LeoWPereira/Dalle-Pad/README.md

# Dalle-Pad
Projeto de Oficinas de Integração 3. Dalle Pad (C) - O Gadget que te transforma em um DJ 

Para que seja possível o completo acompanhamento do projeto, a leitura de todos os itens dentro da pasta "Referências Bibliográficas" é OBRIGATÓRIA!!
