LeoWPereira/Dalle-Pad/LaTeX Project/Apendice.tex

%%
%% Apendice.tex
%% Projeto Oficinas de Integração 3
%% Created by Leonardo Winter Pereira and Lucas Zimmermann Cordeiro on 10.03.2016
%% Copyright (C). All rights reserved
%%

%% Apêndice é um texto ou documento elaborado pelo autor do TC, ou seja,
%% se foi necessário você criar uma entrevista, um relatório, ou qualquer
%% documento com o escopo de complementar sua argumentação

\definecolor{darkRed}{rgb}{0.607843137254902, 0.1764705882352941, 0.1215686274509804}
\definecolor{lightRed}{rgb}{0.9568627450980392, 0.803921568627451, 0.7843137254901961}

\newcolumntype{C}[1]{>{\centering\let\newline\\\arraybackslash\hspace{0pt}}m{#1}}

\chapter{Datasheets}
\label{chap:Team_datasheets}

\chapter{Notas musicais em MIDI}

    O estudo da música em si está fora do escopo deste projeto. Entretanto, é imprescindível entender o que é uma oitava. Segue uma breve definição: \epigraph{Uma oitava é o intervalo entre uma nota musical e outra com a metade ou o dobro de sua frequência.}{~\cite{WikipediaOitava}}

    Dizer que uma nota está uma oitava acima significa dizer que a nota é a mesma, porém ela está em uma região mais aguda do instrumento.

    \begin{table}[H]
        \centering
        \begin{tabular}{| c | c | c | c | c | c | c | c | c | c | c | c | c |}
            \hline
            \rowcolor{darkRed} & \multicolumn{12}{c|}{\textcolor{white}{\textbf{Número referente a nota}}} \\
            \cline{2-13}
            \rowcolor{darkRed} \multirow{-2}{*}{\textcolor{white}{\textbf{Oitava}}} & \textcolor{white}{\textbf{C}} & \textcolor{white}{\textbf{C\#}} & \textcolor{white}{\textbf{D}} & \textcolor{white}{\textbf{D\#}} & \textcolor{white}{\textbf{E}} & \textcolor{white}{\textbf{F}} & \textcolor{white}{\textbf{F\#}} & \textcolor{white}{\textbf{G}} & \textcolor{white}{\textbf{G\#}} & \textcolor{white}{\textbf{A}} & \textcolor{white}{\textbf{A\#}} & \textcolor{white}{\textbf{B}} \\
            \hline
            \rowcolor{lightRed} \textbf{-1} &  0   & 1   & 2   & 3   & 4   & 5   & 6   & 7   & 8   & 9   & 10 & 11 \\
            \hline
            \rowcolor{white}     \textbf{0} &  12  & 13  & 14  & 15  & 16  & 17  & 18  & 19  & 20  & 21  & 22 & 23 \\
            \hline
            \rowcolor{lightRed}  \textbf{1} &  24  & 25  & 26  & 27  & 28  & 29  & 30  & 31  & 32  & 33  & 34 & 35 \\
            \hline
            \rowcolor{white}     \textbf{2} &  36  & 37  & 38  & 39  & 40  & 41  & 42  & 43  & 44  & 45  & 46 & 47 \\
            \hline
            \rowcolor{lightRed}  \textbf{3} &  48  & 49  & 50  & 51  & 52  & 53  & 54  & 55  & 56  & 57  & 58 & 59 \\
            \hline
            \rowcolor{white}     \textbf{4} &  60  & 61  & 62  & 63  & 64  & 65  & 66  & 67  & 68  & 69  & 70 & 71 \\
            \hline
            \rowcolor{lightRed}  \textbf{5} &  72  & 73  & 74  & 75  & 76  & 77  & 78  & 79  & 80  & 81  & 82 & 83 \\
            \hline
            \rowcolor{white}     \textbf{6} &  84  & 85  & 86  & 87  & 88  & 89  & 90  & 91  & 92  & 93  & 94 & 95 \\
            \hline
            \rowcolor{lightRed}  \textbf{7} &  96  & 97  & 98  & 99  & 100 & 101 & 102 & 103 & 104 & 105 & 106 & 107 \\
            \hline
            \rowcolor{white}     \textbf{8} &  108 & 109 & 110 & 111 & 112 & 113 & 114 & 115 & 116 & 117 & 118 & 119 \\
            \hline
            \rowcolor{lightRed}  \textbf{9} &  120 & 121 & 122 & 123 & 124 & 125 & 126 & 127 &     &     &     &     \\
            \hline
        \end{tabular}
        \caption{Notas musicais em MIDI}
        \label{table:MIDI_notes}
    \end{table}

\chapter{Especificação MIDI}

    As seguintes tabelas representam a especificação MIDI, atualizada em 1995 pela \sigla{MMA}{MIDI Manufacturers Association} (Associação dos Fabricantes de MIDI, em inglês), que define o protocolo MIDI.

    \section{Bytes de estado}

        Nas tabelas a seguir, separadas entre os possíveis estados de uma mensagem MIDI, serão citados todos os possíveis valores de \textit{bytes} de estado e o que cada um deles representa.

        %%%%%%%%%%%%%%%%%%%%%%%%%%%%%%%%%%%%%%%%%
        %                                       %
        %             Tabela B.1                %
        %                                       %
        %%%%%%%%%%%%%%%%%%%%%%%%%%%%%%%%%%%%%%%%%

        \begin{center}
        \tablefirsthead{%
          \hline
          \rowcolor{darkRed} \multicolumn{4}{c}{\textcolor{white}{\textbf{Byte de estado}}} & \multicolumn{2}{c}{\textcolor{white}{\textbf{Byte de dados}}} \\
          \hline
          \rowcolor{darkRed} \textcolor{white}{\textbf{\shortstack{1$^\circ$ Byte \\ Binário}}} & \textcolor{white}{\textbf{\shortstack{1$^\circ$ Byte \\ Hexa}}} & \textcolor{white}{\textbf{\shortstack{1$^\circ$ Byte \\ Decimal}}} & \textcolor{white}{\textbf{\shortstack{Função \\ Note OFF}}} & \textcolor{white}{\textbf{2$^\circ$ Byte}} & \textcolor{white}{\textbf{3$^\circ$ Byte}} \\
          \hline}
        \tablehead{%
          \hline
          \multicolumn{6}{|l|}{\small\sl continuação da página anterior} \\
          \hline
          \rowcolor{darkRed} \multicolumn{4}{c|}{\textcolor{white}{\textbf{Byte de estado}}} & \multicolumn{2}{c|}{\textcolor{white}{\textbf{Byte de dados}}} \\
          \hline
          \rowcolor{darkRed} \textcolor{white}{\textbf{\shortstack{1$^\circ$ Byte \\ Binário}}} & \textcolor{white}{\textbf{\shortstack{1$^\circ$ Byte \\ Hexa}}} & \textcolor{white}{\textbf{\shortstack{1$^\circ$ Byte \\ Decimal}}} & \textcolor{white}{\textbf{\shortstack{Função \\ Note OFF}}} & \textcolor{white}{\textbf{2$^\circ$ Byte}} & \textcolor{white}{\textbf{3$^\circ$ Byte}} \\
          \hline}
        \tabletail{%
          \hline
          \multicolumn{6}{|r|}{\small\sl continua na próxima página} \\
          \hline}
        \tablelasttail{\hline}
        \bottomcaption{Lista de Bytes de estado para a função Note Off
        \label{table:MIDI_noteOFF}}
        %
        \begin{supertabular}{| C{2cm} | C{1.5cm} | C{1.5cm} | C{5.3cm} | C{1.5cm} | C{1.5cm} |}
            \rowcolor{lightRed} 10000000 & 80 & 128 & Chan 1   &           Número da nota (0-127)       &          Velocidade da nota (0-127)        \\
            \rowcolor{white}    10000001 & 81 & 129 & Chan 2   &                   "                    &                    "                       \\
            \rowcolor{lightRed} 10000010 & 82 & 130 & Chan 3   &                   "                    &                    "                       \\
            \rowcolor{white}    10000011 & 83 & 131 & Chan 4   &                   "                    &                    "                       \\
            \rowcolor{lightRed} 10000100 & 84 & 132 & Chan 5   &                   "                    &                    "                       \\
            \rowcolor{white}    10000101 & 85 & 133 & Chan 6   &                   "                    &                    "                       \\
            \rowcolor{lightRed} 10000110 & 86 & 134 & Chan 7   &                   "                    &                    "                       \\
            \rowcolor{white}    10000111 & 87 & 135 & Chan 8   &                   "                    &                    "                       \\
            \rowcolor{lightRed} 10001000 & 88 & 136 & Chan 9   &                   "                    &                    "                       \\
            \rowcolor{white}    10001001 & 89 & 137 & Chan 10  &                   "                    &                    "                       \\
            \rowcolor{lightRed} 10001010 & 8A & 138 & Chan 11  &                   "                    &                    "                       \\
            \rowcolor{white}    10001011 & 8B & 139 & Chan 12  &                   "                    &                    "                       \\
            \rowcolor{lightRed} 10001100 & 8C & 140 & Chan 13  &                   "                    &                    "                       \\
            \rowcolor{white}    10001101 & 8D & 141 & Chan 14  &                   "                    &                    "                       \\
            \rowcolor{lightRed} 10001110 & 8E & 142 & Chan 15  &                   "                    &                    "                       \\
            \rowcolor{white}    10001111 & 8F & 143 & Chan 16  &                   "                    &                    "                       \\
        \end{supertabular}
        \end{center}

        %%%%%%%%%%%%%%%%%%%%%%%%%%%%%%%%%%%%%%%%%
        %                                       %
        %             Tabela B.2                %
        %                                       %
        %%%%%%%%%%%%%%%%%%%%%%%%%%%%%%%%%%%%%%%%%

        \begin{center}
        \tablefirsthead{%
          \hline
          \rowcolor{darkRed} \multicolumn{4}{c}{\textcolor{white}{\textbf{Byte de estado}}} & \multicolumn{2}{c}{\textcolor{white}{\textbf{Byte de dados}}} \\
          \hline
          \rowcolor{darkRed} \textcolor{white}{\textbf{\shortstack{1$^\circ$ Byte \\ Binário}}} & \textcolor{white}{\textbf{\shortstack{1$^\circ$ Byte \\ Hexa}}} & \textcolor{white}{\textbf{\shortstack{1$^\circ$ Byte \\ Decimal}}} & \textcolor{white}{\textbf{\shortstack{Função \\ Note ON}}} & \textcolor{white}{\textbf{2$^\circ$ Byte}} & \textcolor{white}{\textbf{3$^\circ$ Byte}} \\
          \hline}
        \tablehead{%
          \hline
          \multicolumn{6}{|l|}{\small\sl continuação da página anterior} \\
          \hline
          \rowcolor{darkRed} \multicolumn{4}{c|}{\textcolor{white}{\textbf{Byte de estado}}} & \multicolumn{2}{c|}{\textcolor{white}{\textbf{Byte de dados}}} \\
          \hline
          \rowcolor{darkRed} \textcolor{white}{\textbf{\shortstack{1$^\circ$ Byte \\ Binário}}} & \textcolor{white}{\textbf{\shortstack{1$^\circ$ Byte \\ Hexa}}} & \textcolor{white}{\textbf{\shortstack{1$^\circ$ Byte \\ Decimal}}} & \textcolor{white}{\textbf{\shortstack{Função \\ Note OFF}}} & \textcolor{white}{\textbf{2$^\circ$ Byte}} & \textcolor{white}{\textbf{3$^\circ$ Byte}} \\
          \hline}
        \tabletail{%
          \hline
          \multicolumn{6}{|r|}{\small\sl continua na próxima página} \\
          \hline}
        \tablelasttail{\hline}
        \bottomcaption{Lista de Bytes de estado para a função Note On
        \label{table:MIDI_noteON}}
        %
        \begin{supertabular}{| C{2cm} | C{1.5cm} | C{1.5cm} | C{5.3cm} | C{1.5cm} | C{1.5cm} |}
            \rowcolor{lightRed} 10010000 & 90 & 144 & Chan 1   &        Número da nota (0-127)          &          Velocidade da nota (0-127)        \\
            \rowcolor{white}    10010001 & 91 & 145 & Chan 2   &                   "                    &                    "                       \\
            \rowcolor{lightRed} 10010010 & 92 & 146 & Chan 3   &                   "                    &                    "                       \\
            \rowcolor{white}    10010011 & 93 & 147 & Chan 4   &                   "                    &                    "                       \\
            \rowcolor{lightRed} 10010100 & 94 & 148 & Chan 5   &                   "                    &                    "                       \\
            \rowcolor{white}    10010101 & 95 & 149 & Chan 6   &                   "                    &                    "                       \\
            \rowcolor{lightRed} 10010110 & 96 & 150 & Chan 7   &                   "                    &                    "                       \\
            \rowcolor{white}    10010111 & 97 & 151 & Chan 8   &                   "                    &                    "                       \\
            \rowcolor{lightRed} 10011000 & 98 & 152 & Chan 9   &                   "                    &                    "                       \\
            \rowcolor{white}    10011001 & 99 & 153 & Chan 10  &                   "                    &                    "                       \\
            \rowcolor{lightRed} 10011010 & 9A & 154 & Chan 11  &                   "                    &                    "                       \\
            \rowcolor{white}    10011011 & 9B & 155 & Chan 12  &                   "                    &                    "                       \\
            \rowcolor{lightRed} 10011100 & 9C & 156 & Chan 13  &                   "                    &                    "                       \\
            \rowcolor{white}    10011101 & 9D & 157 & Chan 14  &                   "                    &                    "                       \\
            \rowcolor{lightRed} 10011110 & 9E & 158 & Chan 15  &                   "                    &                    "                       \\
            \rowcolor{white}    10011111 & 9F & 159 & Chan 16  &                   "                    &                    "                       \\
        \end{supertabular}
        \end{center}

        %%%%%%%%%%%%%%%%%%%%%%%%%%%%%%%%%%%%%%%%%
        %                                       %
        %             Tabela B.3                %
        %                                       %
        %%%%%%%%%%%%%%%%%%%%%%%%%%%%%%%%%%%%%%%%%

        \begin{center}
        \tablefirsthead{%
          \hline
          \rowcolor{darkRed} \multicolumn{4}{c}{\textcolor{white}{\textbf{Byte de estado}}} & \multicolumn{2}{c}{\textcolor{white}{\textbf{Byte de dados}}} \\
          \hline
          \rowcolor{darkRed} \textcolor{white}{\textbf{\shortstack{1$^\circ$ Byte \\ Binário}}} & \textcolor{white}{\textbf{\shortstack{1$^\circ$ Byte \\ Hexa}}} & \textcolor{white}{\textbf{\shortstack{1$^\circ$ Byte \\ Decimal}}} & \textcolor{white}{\textbf{\shortstack{Função \\ Polyphonic  \\ Aftertouch}}} & \textcolor{white}{\textbf{2$^\circ$ Byte}} & \textcolor{white}{\textbf{3$^\circ$ Byte}} \\
          \hline}
        \tablehead{%
          \hline
          \multicolumn{6}{|l|}{\small\sl continuação da página anterior} \\
          \hline
          \rowcolor{darkRed} \multicolumn{4}{c|}{\textcolor{white}{\textbf{Byte de estado}}} & \multicolumn{2}{c|}{\textcolor{white}{\textbf{Byte de dados}}} \\
          \hline
          \rowcolor{darkRed} \textcolor{white}{\textbf{\shortstack{1$^\circ$ Byte \\ Binário}}} & \textcolor{white}{\textbf{\shortstack{1$^\circ$ Byte \\ Hexa}}} & \textcolor{white}{\textbf{\shortstack{1$^\circ$ Byte \\ Decimal}}} & \textcolor{white}{\textbf{\shortstack{Função \\ Polyphonic  \\ Aftertouch}}} & \textcolor{white}{\textbf{2$^\circ$ Byte}} & \textcolor{white}{\textbf{3$^\circ$ Byte}} \\
          \hline}
        \tabletail{%
          \hline
          \multicolumn{6}{|r|}{\small\sl continua na próxima página} \\
          \hline}
        \tablelasttail{\hline}
        \bottomcaption{Lista de Bytes de estado para a função Polyphonic Aftertouch
        \label{table:MIDI_polyphonic_Afetertouch}}
        %
        \begin{supertabular}{| C{2cm} | C{1.5cm} | C{1.5cm} | C{5.3cm} | C{1.5cm} | C{1.5cm} |}
            \rowcolor{lightRed} 10100000 & A0 & 160 & Chan 1   &         Número da nota (0-127)         &          Valor do aftertouch (0-127)        \\
            \rowcolor{white}    10100001 & A1 & 161 & Chan 2   &                   "                    &                    "                        \\
            \rowcolor{lightRed} 10100010 & A2 & 162 & Chan 3   &                   "                    &                    "                        \\
            \rowcolor{white}    10100011 & A3 & 163 & Chan 4   &                   "                    &                    "                        \\
            \rowcolor{lightRed} 10100100 & A4 & 164 & Chan 5   &                   "                    &                    "                        \\
            \rowcolor{white}    10100101 & A5 & 165 & Chan 6   &                   "                    &                    "                        \\
            \rowcolor{lightRed} 10100110 & A6 & 166 & Chan 7   &                   "                    &                    "                        \\
            \rowcolor{white}    10100111 & A7 & 167 & Chan 8   &                   "                    &                    "                        \\
            \rowcolor{lightRed} 10101000 & A8 & 168 & Chan 9   &                   "                    &                    "                        \\
            \rowcolor{white}    10101001 & A9 & 169 & Chan 10  &                   "                    &                    "                        \\
            \rowcolor{lightRed} 10101010 & AA & 170 & Chan 11  &                   "                    &                    "                        \\
            \rowcolor{white}    10101011 & AB & 171 & Chan 12  &                   "                    &                    "                        \\
            \rowcolor{lightRed} 10101100 & AC & 172 & Chan 13  &                   "                    &                    "                        \\
            \rowcolor{white}    10101101 & AD & 173 & Chan 14  &                   "                    &                    "                        \\
            \rowcolor{lightRed} 10101110 & AE & 174 & Chan 15  &                   "                    &                    "                        \\
            \rowcolor{white}    10101111 & AF & 175 & Chan 16  &                   "                    &                    "                        \\
        \end{supertabular}
        \end{center}

        %%%%%%%%%%%%%%%%%%%%%%%%%%%%%%%%%%%%%%%%%
        %                                       %
        %             Tabela B.4                %
        %                                       %
        %%%%%%%%%%%%%%%%%%%%%%%%%%%%%%%%%%%%%%%%%

        \begin{center}
        \tablefirsthead{%
          \hline
          \rowcolor{darkRed} \multicolumn{4}{c}{\textcolor{white}{\textbf{Byte de estado}}} & \multicolumn{2}{c}{\textcolor{white}{\textbf{Byte de dados}}} \\
          \hline
          \rowcolor{darkRed} \textcolor{white}{\textbf{\shortstack{1$^\circ$ Byte \\ Binário}}} & \textcolor{white}{\textbf{\shortstack{1$^\circ$ Byte \\ Hexa}}} & \textcolor{white}{\textbf{\shortstack{1$^\circ$ Byte \\ Decimal}}} & \textcolor{white}{\textbf{\shortstack{Função \\ de controle  \\ Modo de Canal}}} & \textcolor{white}{\textbf{2$^\circ$ Byte}} & \textcolor{white}{\textbf{3$^\circ$ Byte}} \\
          \hline}
        \tablehead{%
          \hline
          \multicolumn{6}{|l|}{\small\sl continuação da página anterior} \\
          \hline
          \rowcolor{darkRed} \multicolumn{4}{c|}{\textcolor{white}{\textbf{Byte de estado}}} & \multicolumn{2}{c|}{\textcolor{white}{\textbf{Byte de dados}}} \\
          \hline
          \rowcolor{darkRed} \textcolor{white}{\textbf{\shortstack{1$^\circ$ Byte \\ Binário}}} & \textcolor{white}{\textbf{\shortstack{1$^\circ$ Byte \\ Hexa}}} & \textcolor{white}{\textbf{\shortstack{1$^\circ$ Byte \\ Decimal}}} & \textcolor{white}{\textbf{\shortstack{Função \\ de controle  \\ Modo de Canal}}} & \textcolor{white}{\textbf{2$^\circ$ Byte}} & \textcolor{white}{\textbf{3$^\circ$ Byte}} \\
          \hline}
        \tabletail{%
          \hline
          \multicolumn{6}{|r|}{\small\sl continua na próxima página} \\
          \hline}
        \tablelasttail{\hline}
        \bottomcaption{Lista de Bytes de estado para mudança de controle / modo de canal
        \label{table:MIDI_polyphonic_controlChange_and_Channel}}
        %
        \begin{supertabular}{| C{2cm} | C{1.5cm} | C{1.5cm} | C{5.3cm} | C{1.5cm} | C{1.5cm} |}
            \rowcolor{lightRed} 10110000 & B0 & 176 & Chan 1   &    Veja tabela ~\ref{table:MIDI_control_and_channel_messages} (0-127) &         Veja tabela  ~\ref{table:MIDI_control_and_channel_messages} (0-127) \\
            \rowcolor{white}    10110001 & B1 & 177 & Chan 2   &                   "                    &                    "                        \\
            \rowcolor{lightRed} 10110010 & B2 & 178 & Chan 3   &                   "                    &                    "                        \\
            \rowcolor{white}    10110011 & B3 & 179 & Chan 4   &                   "                    &                    "                        \\
            \rowcolor{lightRed} 10110100 & B4 & 180 & Chan 5   &                   "                    &                    "                        \\
            \rowcolor{white}    10110101 & B5 & 181 & Chan 6   &                   "                    &                    "                        \\
            \rowcolor{lightRed} 10110110 & B6 & 182 & Chan 7   &                   "                    &                    "                        \\
            \rowcolor{white}    10110111 & B7 & 183 & Chan 8   &                   "                    &                    "                        \\
            \rowcolor{lightRed} 10111000 & B8 & 184 & Chan 9   &                   "                    &                    "                        \\
            \rowcolor{white}    10111001 & B9 & 185 & Chan 10  &                   "                    &                    "                        \\
            \rowcolor{lightRed} 10111010 & BA & 186 & Chan 11  &                   "                    &                    "                        \\
            \rowcolor{white}    10111011 & BB & 187 & Chan 12  &                   "                    &                    "                        \\
            \rowcolor{lightRed} 10111100 & BC & 188 & Chan 13  &                   "                    &                    "                        \\
            \rowcolor{white}    10111101 & BD & 189 & Chan 14  &                   "                    &                    "                        \\
            \rowcolor{lightRed} 10111110 & BE & 190 & Chan 15  &                   "                    &                    "                        \\
            \rowcolor{white}    10111111 & BF & 191 & Chan 16  &                   "                    &                    "                        \\
        \end{supertabular}
        \end{center}

        %%%%%%%%%%%%%%%%%%%%%%%%%%%%%%%%%%%%%%%%%
        %                                       %
        %             Tabela B.5                %
        %                                       %
        %%%%%%%%%%%%%%%%%%%%%%%%%%%%%%%%%%%%%%%%%

        \begin{center}
        \tablefirsthead{%
          \hline
          \rowcolor{darkRed} \multicolumn{4}{c}{\textcolor{white}{\textbf{Byte de estado}}} & \multicolumn{2}{c}{\textcolor{white}{\textbf{Byte de dados}}} \\
          \hline
          \rowcolor{darkRed} \textcolor{white}{\textbf{\shortstack{1$^\circ$ Byte \\ Binário}}} & \textcolor{white}{\textbf{\shortstack{1$^\circ$ Byte \\ Hexa}}} & \textcolor{white}{\textbf{\shortstack{1$^\circ$ Byte \\ Decimal}}} & \textcolor{white}{\textbf{\shortstack{Função \\ Mudança de Programa}}} & \textcolor{white}{\textbf{2$^\circ$ Byte}} & \textcolor{white}{\textbf{3$^\circ$ Byte}} \\
          \hline}
        \tablehead{%
          \hline
          \multicolumn{6}{|l|}{\small\sl continuação da página anterior} \\
          \hline
          \rowcolor{darkRed} \multicolumn{4}{c|}{\textcolor{white}{\textbf{Byte de estado}}} & \multicolumn{2}{c|}{\textcolor{white}{\textbf{Byte de dados}}} \\
          \hline
          \rowcolor{darkRed} \textcolor{white}{\textbf{\shortstack{1$^\circ$ Byte \\ Binário}}} & \textcolor{white}{\textbf{\shortstack{1$^\circ$ Byte \\ Hexa}}} & \textcolor{white}{\textbf{\shortstack{1$^\circ$ Byte \\ Decimal}}} & \textcolor{white}{\textbf{\shortstack{Função \\ Mudança de Programa}}} & \textcolor{white}{\textbf{2$^\circ$ Byte}} & \textcolor{white}{\textbf{3$^\circ$ Byte}} \\
          \hline}
        \tabletail{%
          \hline
          \multicolumn{6}{|r|}{\small\sl continua na próxima página} \\
          \hline}
        \tablelasttail{\hline}
        \bottomcaption{Lista de Bytes de estado para a função mudança de programa
        \label{table:MIDI_program_change}}
        %
        \begin{supertabular}{| C{2cm} | C{1.5cm} | C{1.5cm} | C{5.3cm} | C{1.5cm} | C{1.5cm} |}
            \rowcolor{lightRed} 11000000 & C0 & 192 & Chan 1   &            Programa (0-127)            &                   Nulo                      \\
            \rowcolor{white}    11000001 & C1 & 193 & Chan 2   &                   "                    &                    "                        \\
            \rowcolor{lightRed} 11000010 & C2 & 194 & Chan 3   &                   "                    &                    "                        \\
            \rowcolor{white}    11000011 & C3 & 195 & Chan 4   &                   "                    &                    "                        \\
            \rowcolor{lightRed} 11000100 & C4 & 196 & Chan 5   &                   "                    &                    "                        \\
            \rowcolor{white}    11000101 & C5 & 197 & Chan 6   &                   "                    &                    "                        \\
            \rowcolor{lightRed} 11000110 & C6 & 198 & Chan 7   &                   "                    &                    "                        \\
            \rowcolor{white}    11000111 & C7 & 199 & Chan 8   &                   "                    &                    "                        \\
            \rowcolor{lightRed} 11001000 & C8 & 200 & Chan 9   &                   "                    &                    "                        \\
            \rowcolor{white}    11001001 & C9 & 201 & Chan 10  &                   "                    &                    "                        \\
            \rowcolor{lightRed} 11001010 & CA & 202 & Chan 11  &                   "                    &                    "                        \\
            \rowcolor{white}    11001011 & CB & 203 & Chan 12  &                   "                    &                    "                        \\
            \rowcolor{lightRed} 11001100 & CC & 204 & Chan 13  &                   "                    &                    "                        \\
            \rowcolor{white}    11001101 & CD & 205 & Chan 14  &                   "                    &                    "                        \\
            \rowcolor{lightRed} 11001110 & CE & 206 & Chan 15  &                   "                    &                    "                        \\
            \rowcolor{white}    11001111 & CF & 207 & Chan 16  &                   "                    &                    "                        \\
        \end{supertabular}
        \end{center}

        %%%%%%%%%%%%%%%%%%%%%%%%%%%%%%%%%%%%%%%%%
        %                                       %
        %             Tabela B.6                %
        %                                       %
        %%%%%%%%%%%%%%%%%%%%%%%%%%%%%%%%%%%%%%%%%

        \begin{center}
        \tablefirsthead{%
          \hline
          \rowcolor{darkRed} \multicolumn{4}{c}{\textcolor{white}{\textbf{Byte de estado}}} & \multicolumn{2}{c}{\textcolor{white}{\textbf{Byte de dados}}} \\
          \hline
          \rowcolor{darkRed} \textcolor{white}{\textbf{\shortstack{1$^\circ$ Byte \\ Binário}}} & \textcolor{white}{\textbf{\shortstack{1$^\circ$ Byte \\ Hexa}}} & \textcolor{white}{\textbf{\shortstack{1$^\circ$ Byte \\ Decimal}}} & \textcolor{white}{\textbf{\shortstack{Função \\ Channel Aftertouch}}} & \textcolor{white}{\textbf{2$^\circ$ Byte}} & \textcolor{white}{\textbf{3$^\circ$ Byte}} \\
          \hline}
        \tablehead{%
          \hline
          \multicolumn{6}{|l|}{\small\sl continuação da página anterior} \\
          \hline
          \rowcolor{darkRed} \multicolumn{4}{c|}{\textcolor{white}{\textbf{Byte de estado}}} & \multicolumn{2}{c|}{\textcolor{white}{\textbf{Byte de dados}}} \\
          \hline
          \rowcolor{darkRed} \textcolor{white}{\textbf{\shortstack{1$^\circ$ Byte \\ Binário}}} & \textcolor{white}{\textbf{\shortstack{1$^\circ$ Byte \\ Hexa}}} & \textcolor{white}{\textbf{\shortstack{1$^\circ$ Byte \\ Decimal}}} & \textcolor{white}{\textbf{\shortstack{Função \\ Channel Aftertouch}}} & \textcolor{white}{\textbf{2$^\circ$ Byte}} & \textcolor{white}{\textbf{3$^\circ$ Byte}} \\
          \hline}
        \tabletail{%
          \hline
          \multicolumn{6}{|r|}{\small\sl continua na próxima página} \\
          \hline}
        \tablelasttail{\hline}
        \bottomcaption{Lista de Bytes de estado para a função Channel Aftertouch
        \label{table:MIDI_channel_aftertouch}}
        %
        \begin{supertabular}{| C{2cm} | C{1.5cm} | C{1.5cm} | C{5.3cm} | C{1.5cm} | C{1.5cm} |}
            \rowcolor{lightRed} 11010000 & D0 & 208 & Chan 1   &              Valor do aftertouch (0-127)          &                   Nulo                      \\
            \rowcolor{white}    11010000 & D1 & 209 & Chan 2   &                              "                    &                    "                        \\
            \rowcolor{lightRed} 11010000 & D2 & 210 & Chan 3   &                              "                    &                    "                        \\
            \rowcolor{white}    11010000 & D3 & 211 & Chan 4   &                              "                    &                    "                        \\
            \rowcolor{lightRed} 11010000 & D4 & 212 & Chan 5   &                              "                    &                    "                        \\
            \rowcolor{white}    11010000 & D5 & 213 & Chan 6   &                              "                    &                    "                        \\
            \rowcolor{lightRed} 11010000 & D6 & 214 & Chan 7   &                              "                    &                    "                        \\
            \rowcolor{white}    11010000 & D7 & 215 & Chan 8   &                              "                    &                    "                        \\
            \rowcolor{lightRed} 11010000 & D8 & 216 & Chan 9   &                              "                    &                    "                        \\
            \rowcolor{white}    11010000 & D9 & 217 & Chan 10  &                              "                    &                    "                        \\
            \rowcolor{lightRed} 11010000 & DA & 218 & Chan 11  &                              "                    &                    "                        \\
            \rowcolor{white}    11010000 & DB & 219 & Chan 12  &                              "                    &                    "                        \\
            \rowcolor{lightRed} 11010000 & DC & 220 & Chan 13  &                              "                    &                    "                        \\
            \rowcolor{white}    11010000 & DD & 221 & Chan 14  &                              "                    &                    "                        \\
            \rowcolor{lightRed} 11010000 & DE & 222 & Chan 15  &                              "                    &                    "                        \\
            \rowcolor{white}    11010000 & DF & 223 & Chan 16  &                              "                    &                    "                        \\
        \end{supertabular}
        \end{center}

        %%%%%%%%%%%%%%%%%%%%%%%%%%%%%%%%%%%%%%%%%
        %                                       %
        %             Tabela B.7                %
        %                                       %
        %%%%%%%%%%%%%%%%%%%%%%%%%%%%%%%%%%%%%%%%%

        \begin{center}
        \tablefirsthead{%
          \hline
          \rowcolor{darkRed} \multicolumn{4}{c}{\textcolor{white}{\textbf{Byte de estado}}} & \multicolumn{2}{c}{\textcolor{white}{\textbf{Byte de dados}}} \\
          \hline
          \rowcolor{darkRed} \textcolor{white}{\textbf{\shortstack{1$^\circ$ Byte \\ Binário}}} & \textcolor{white}{\textbf{\shortstack{1$^\circ$ Byte \\ Hexa}}} & \textcolor{white}{\textbf{\shortstack{1$^\circ$ Byte \\ Decimal}}} & \textcolor{white}{\textbf{\shortstack{Função \\ Pitch Wheel}}} & \textcolor{white}{\textbf{2$^\circ$ Byte}} & \textcolor{white}{\textbf{3$^\circ$ Byte}} \\
          \hline}
        \tablehead{%
          \hline
          \multicolumn{6}{|l|}{\small\sl continuação da página anterior} \\
          \hline
          \rowcolor{darkRed} \multicolumn{4}{c|}{\textcolor{white}{\textbf{Byte de estado}}} & \multicolumn{2}{c|}{\textcolor{white}{\textbf{Byte de dados}}} \\
          \hline
          \rowcolor{darkRed} \textcolor{white}{\textbf{\shortstack{1$^\circ$ Byte \\ Binário}}} & \textcolor{white}{\textbf{\shortstack{1$^\circ$ Byte \\ Hexa}}} & \textcolor{white}{\textbf{\shortstack{1$^\circ$ Byte \\ Decimal}}} & \textcolor{white}{\textbf{\shortstack{Função \\ Pitch Wheel}}} & \textcolor{white}{\textbf{2$^\circ$ Byte}} & \textcolor{white}{\textbf{3$^\circ$ Byte}} \\
          \hline}
        \tabletail{%
          \hline
          \multicolumn{6}{|r|}{\small\sl continua na próxima página} \\
          \hline}
        \tablelasttail{\hline}
        \bottomcaption{Lista de Bytes de estado para a função de controle do Pitch Wheel
        \label{table:MIDI_pitch_wheel}}
        %
        \begin{supertabular}{| C{2cm} | C{1.5cm} | C{1.5cm} | C{5.3cm} | C{1.5cm} | C{1.5cm} |}
            \rowcolor{lightRed} 11100000 & E0 & 224 & Chan 1   &           LSB Pitch Wheel (0-127)                &         MSB Pitch Wheel (0-127)                \\
            \rowcolor{white}    11100001 & E1 & 225 & Chan 2   &                   "                              &                   "                            \\
            \rowcolor{lightRed} 11100010 & E2 & 226 & Chan 3   &                   "                              &                   "                            \\
            \rowcolor{white}    11100011 & E3 & 227 & Chan 4   &                   "                              &                   "                            \\
            \rowcolor{lightRed} 11100100 & E4 & 228 & Chan 5   &                   "                              &                   "                            \\
            \rowcolor{white}    11100101 & E5 & 229 & Chan 6   &                   "                              &                   "                            \\
            \rowcolor{lightRed} 11100110 & E6 & 230 & Chan 7   &                   "                              &                   "                            \\
            \rowcolor{white}    11100111 & E7 & 231 & Chan 8   &                   "                              &                   "                            \\
            \rowcolor{lightRed} 11101000 & E8 & 232 & Chan 9   &                   "                              &                   "                            \\
            \rowcolor{white}    11101001 & E9 & 233 & Chan 10  &                   "                              &                   "                            \\
            \rowcolor{lightRed} 11101010 & EA & 234 & Chan 11  &                   "                              &                   "                            \\
            \rowcolor{white}    11101011 & EB & 235 & Chan 12  &                   "                              &                   "                            \\
            \rowcolor{lightRed} 11101100 & EC & 236 & Chan 13  &                   "                              &                   "                            \\
            \rowcolor{white}    11101101 & ED & 237 & Chan 14  &                   "                              &                   "                            \\
            \rowcolor{lightRed} 11101110 & EE & 239 & Chan 15  &                   "                              &                   "                            \\
            \rowcolor{white}    11101111 & EF & 239 & Chan 16  &                   "                              &                   "                            \\
        \end{supertabular}
        \end{center}

        %%%%%%%%%%%%%%%%%%%%%%%%%%%%%%%%%%%%%%%%%
        %                                       %
        %             Tabela B.8                %
        %                                       %
        %%%%%%%%%%%%%%%%%%%%%%%%%%%%%%%%%%%%%%%%%

        \begin{center}
        \tablefirsthead{%
          \hline
          \rowcolor{darkRed} \multicolumn{4}{c}{\textcolor{white}{\textbf{Byte de estado}}} & \multicolumn{2}{c}{\textcolor{white}{\textbf{Byte de dados}}} \\
          \hline
          \rowcolor{darkRed} \textcolor{white}{\textbf{\shortstack{1$^\circ$ Byte \\ Binário}}} & \textcolor{white}{\textbf{\shortstack{1$^\circ$ Byte \\ Hexa}}} & \textcolor{white}{\textbf{\shortstack{1$^\circ$ Byte \\ Decimal}}} & \textcolor{white}{\textbf{\shortstack{Função \\ Mensagem}}} & \textcolor{white}{\textbf{2$^\circ$ Byte}} & \textcolor{white}{\textbf{3$^\circ$ Byte}} \\
          \hline}
        \tablehead{%
          \hline
          \multicolumn{6}{|l|}{\small\sl continuação da página anterior} \\
          \hline
          \rowcolor{darkRed} \multicolumn{4}{c|}{\textcolor{white}{\textbf{Byte de estado}}} & \multicolumn{2}{c|}{\textcolor{white}{\textbf{Byte de dados}}} \\
          \hline
          \rowcolor{darkRed} \textcolor{white}{\textbf{\shortstack{1$^\circ$ Byte \\ Binário}}} & \textcolor{white}{\textbf{\shortstack{1$^\circ$ Byte \\ Hexa}}} & \textcolor{white}{\textbf{\shortstack{1$^\circ$ Byte \\ Decimal}}} & \textcolor{white}{\textbf{\shortstack{Função \\ Mensagem}}} & \textcolor{white}{\textbf{2$^\circ$ Byte}} & \textcolor{white}{\textbf{3$^\circ$ Byte}} \\
          \hline}
        \tabletail{%
          \hline
          \multicolumn{6}{|r|}{\small\sl continua na próxima página} \\
          \hline}
        \tablelasttail{\hline}
        \bottomcaption{Lista de Bytes de estado para as funções de sistema
        \label{table:MIDI_message}}
        %
        \begin{supertabular}{| C{2cm} | C{1.5cm} | C{1.5cm} | C{5.3cm} | C{1.5cm} | C{1.5cm} |}
            \rowcolor{lightRed} 11110000 & F0 & 240 &            Exclusivo do sistema                 &       Mensagem SysEx Atual           &         Mensagem SysEx Atual         \\
            \rowcolor{white}    11110001 & F1 & 241 &            Código de tempo MIDI                 &       Mensagem tempo Atual           &         Mensagem tempo Atual         \\
            \rowcolor{lightRed} 11110010 & F2 & 242 &        Ponteiro de Posição da música            &               LSB                    &                 MSB                  \\
            \rowcolor{white}    11110011 & F3 & 243 &       Seleção da música (música \#)             &          Valores (0-127)             &                 Nulo                 \\
            \rowcolor{lightRed} 11110100 & F4 & 244 &                Indefinido                       &                N/A                   &                  N/A                 \\
            \rowcolor{white}    11110101 & F5 & 245 &                Indefinido                       &                N/A                   &                  N/A                 \\
            \rowcolor{lightRed} 11110110 & F6 & 246 &            Pedido de Afinação                   &               Nulo                   &                 Nulo                 \\
            \rowcolor{white}    11110111 & F7 & 247 &           Final da SysEx (EOX)                  &                 "                    &                   "                  \\
            \rowcolor{lightRed} 11111000 & F8 & 248 &                Cronômetro                       &                 "                    &                   "                  \\
            \rowcolor{white}    11111001 & F9 & 249 &                Indefinido                       &                 "                    &                   "                  \\
            \rowcolor{lightRed} 11111010 & FA & 250 &                  Iniciar                        &                 "                    &                   "                  \\
            \rowcolor{white}    11111011 & FB & 251 &                 Continuar                       &                 "                    &                   "                  \\
            \rowcolor{lightRed} 11111100 & FC & 252 &                  Pausar                         &                 "                    &                   "                  \\
            \rowcolor{white}    11111101 & FD & 253 &                 Indefinido                      &                 "                    &                   "                  \\
            \rowcolor{lightRed} 11111110 & FE & 254 &             Sensoriamento ativo                 &                 "                    &                   "                  \\
            \rowcolor{white}    11111111 & FF & 255 &               Reset do Sistema                  &                 "                    &                   "                  \\
        \end{supertabular}
        \end{center}

    \section{Bytes de dados}

        A seguinte tabela é uma referência de todas os possíveis mensagens de controle e modos de canais, além de citar o que cada uma delas representa.

        %%%%%%%%%%%%%%%%%%%%%%%%%%%%%%%%%%%%%%%%%
        %                                       %
        %             Tabela B.9                %
        %                                       %
        %%%%%%%%%%%%%%%%%%%%%%%%%%%%%%%%%%%%%%%%%

        \begin{center}
        \tablefirsthead{%
          \hline
          \rowcolor{darkRed} \textcolor{white}{\textbf{\shortstack{2$^\circ$ Byte \\ Binário}}} & \textcolor{white}{\textbf{\shortstack{2$^\circ$ Byte \\ Hexa}}} & \textcolor{white}{\textbf{\shortstack{2$^\circ$ Byte \\ Decimal}}} & \textcolor{white}{\textbf{Função}} & \textcolor{white}{\textbf{\shortstack{3$^\circ$ Byte \\ Valor}}} & \textcolor{white}{\textbf{\shortstack{3$^\circ$ Byte \\ Uso}}} \\
          \hline}
        \tablehead{%
          \hline
          \multicolumn{6}{|l|}{\small\sl continuação da página anterior} \\
          \hline
          \rowcolor{darkRed} \textcolor{white}{\textbf{\shortstack{2$^\circ$ Byte \\ Binário}}} & \textcolor{white}{\textbf{\shortstack{2$^\circ$ Byte \\ Hexa}}} & \textcolor{white}{\textbf{\shortstack{2$^\circ$ Byte \\ Decimal}}} & \textcolor{white}{\textbf{Função}} & \textcolor{white}{\textbf{\shortstack{3$^\circ$ Byte \\ Valor}}} & \textcolor{white}{\textbf{\shortstack{3$^\circ$ Byte \\ Uso}}} \\
          \hline}
        \tabletail{%
          \hline
          \multicolumn{6}{|r|}{\small\sl continua na próxima página} \\
          \hline}
        \tablelasttail{\hline}
        \bottomcaption{Lista de mensagens de mudança de controle / modo de canal (Bytes de estado 176-191)
        \label{table:MIDI_control_and_channel_messages}}
        %
        \begin{supertabular}{| C{2cm} | C{1.5cm} | C{1.5cm} | C{5.3cm} | C{1.5cm} | C{1.5cm} |}
            \rowcolor{lightRed} 00000000 & 00 &  0  & Bank Selection & 0-127 & LSB \\
            \rowcolor{white}    00000001 & 01 &  1  & Modulation wheel & 0-127 & LSB \\
            \rowcolor{lightRed} 00000010 & 02 &  2  & Breath control & 0-127 & LSB \\
            \rowcolor{white}    00000011 & 03 &  3  & Indefinido & 0-127 & LSB \\
            \rowcolor{lightRed} 00000100 & 04 &  4  & Foot controller & 0-127 & LSB \\
            \rowcolor{white}    00000101 & 05 &  5  & Portamento time & 0-127 & LSB \\
            \rowcolor{lightRed} 00000110 & 06 &  6  & Data Entry & 0-127 & LSB \\
            \rowcolor{white}    00000111 & 07 &  7  & Channel Volume (Main Volume) & 0-127 & LSB \\
            \rowcolor{lightRed} 00001000 & 08 &  8  & Balance & 0-127 & LSB \\
            \rowcolor{white}    00001001 & 09 &  9  & Indefinido & 0-127 & LSB \\
            \rowcolor{lightRed} 00001010 & 0A & 10  & Pan & 0-127 & LSB \\
            \rowcolor{white}    00001011 & 0B & 11  & Expression Controller & 0-127 & LSB \\
            \rowcolor{lightRed} 00001100 & 0C & 12  & Effect control 1 & 0-127 & LSB \\
            \rowcolor{white}    00001101 & 0D & 13  & Effect control 2 & 0-127 & LSB \\
            \rowcolor{lightRed} 00001110 & 0E & 14  & Indefinido & 0-127 & LSB \\
            \rowcolor{white}    00001111 & 0F & 15  & Indefinido & 0-127 & LSB \\
            \rowcolor{lightRed} 00010000 & 10 & 16  & General Controller 1 & 0-127 & LSB \\
            \rowcolor{white}    00010001 & 11 & 17  & General Controller 2 & 0-127 & LSB \\
            \rowcolor{lightRed} 00010010 & 12 & 18  & General Controller 3 & 0-127 & LSB \\
            \rowcolor{white}    00010011 & 13 & 19  & General Controller 4 & 0-127 & LSB \\
            \rowcolor{lightRed} 00010100 & 14 & 20  & Indefinido & 0-127 & LSB \\
            \rowcolor{white}    00010101 & 15 & 21  & Indefinido & 0-127 & LSB \\
            \rowcolor{lightRed} 00010110 & 16 & 22  & Indefinido & 0-127 & LSB \\
            \rowcolor{white}    00010111 & 17 & 23  & Indefinido & 0-127 & LSB \\
            \rowcolor{lightRed} 00011000 & 18 & 24  & Indefinido & 0-127 & LSB \\
            \rowcolor{white}    00011001 & 19 & 25  & Indefinido & 0-127 & LSB \\
            \rowcolor{lightRed} 00011010 & 1A & 26  & Indefinido & 0-127 & LSB \\
            \rowcolor{white}    00011011 & 1B & 27  & Indefinido & 0-127 & LSB \\
            \rowcolor{lightRed} 00011100 & 1C & 28  & Indefinido & 0-127 & LSB \\
            \rowcolor{white}    00011101 & 1D & 29  & Indefinido & 0-127 & LSB \\
            \rowcolor{lightRed} 00011110 & 1E & 30  & Indefinido & 0-127 & LSB \\
            \rowcolor{white}    00011111 & 1F & 31  & Indefinido & 0-127 & LSB \\
            \rowcolor{lightRed} 00100000 & 20 & 32  & Bank select & 0-127 & LSB \\
            \rowcolor{white}    00100001 & 21 & 33  & Modulation wheel & 0-127 & LSB \\
            \rowcolor{lightRed} 00100010 & 22 & 34  & Breath control & 0-127 & LSB \\
            \rowcolor{white}    00100011 & 23 & 35  & Indefinido & 0-127 & LSB \\
            \rowcolor{lightRed} 00100100 & 24 & 36  & Foot controller & 0-127 & LSB \\
            \rowcolor{white}    00100101 & 25 & 37  & Portamento time & 0-127 & LSB \\
            \rowcolor{lightRed} 00100110 & 26 & 38  & Data entry & 0-127 & LSB \\
            \rowcolor{white}    00100111 & 27 & 39  & Channel Volume & 0-127 & LSB \\
            \rowcolor{lightRed} 00101000 & 28 & 40  & Balance & 0-127 & LSB \\
            \rowcolor{white}    00101001 & 29 & 41  & Indefinido & 0-127 & LSB \\
            \rowcolor{lightRed} 00101010 & 2A & 42  & Pan & 0-127 & LSB \\
            \rowcolor{white}    00101011 & 2B & 43  & Expression Controller & 0-127 & LSB \\
            \rowcolor{lightRed} 00101100 & 2C & 44  & Effect control 1 & 0-127 & LSB \\
            \rowcolor{white}    00101101 & 2D & 45  & Effect control 2 & 0-127 & LSB \\
            \rowcolor{lightRed} 00101110 & 2E & 46  & Indefinido & 0-127 & LSB \\
            \rowcolor{white}    00101111 & 2F & 47  & Indefinido & 0-127 & LSB \\
            \rowcolor{lightRed} 00110000 & 30 & 48  & General Controller 1 & 0-127 & LSB \\
            \rowcolor{white}    00110001 & 31 & 49  & General Controller 2 & 0-127 & LSB \\
            \rowcolor{lightRed} 00110010 & 32 & 50  & General Controller 3 & 0-127 & LSB \\
            \rowcolor{white}    00110011 & 33 & 51  & General Controller 4 & 0-127 & LSB \\
            \rowcolor{lightRed} 00110100 & 34 & 52  & Indefinido & 0-127 & LSB \\
            \rowcolor{white}    00110101 & 35 & 53  & Indefinido & 0-127 & LSB \\
            \rowcolor{lightRed} 00110110 & 36 & 54  & Indefinido & 0-127 & LSB \\
            \rowcolor{white}    00110111 & 37 & 55  & Indefinido & 0-127 & LSB \\
            \rowcolor{lightRed} 00111000 & 38 & 56  & Indefinido & 0-127 & LSB \\
            \rowcolor{white}    00111001 & 39 & 57  & Indefinido & 0-127 & LSB \\
            \rowcolor{lightRed} 00111010 & 3A & 58  & Indefinido & 0-127 & LSB \\
            \rowcolor{white}    00111011 & 3B & 59  & Indefinido & 0-127 & LSB \\
            \rowcolor{lightRed} 00111100 & 3C & 60  & Indefinido & 0-127 & LSB \\
            \rowcolor{white}    00111101 & 3D & 61  & Indefinido & 0-127 & LSB \\
            \rowcolor{lightRed} 00111110 & 3E & 62  & Indefinido & 0-127 & LSB \\
            \rowcolor{white}    00111111 & 3F & 63  & Indefinido & 0-127 & LSB \\
            \rowcolor{lightRed} 01000000 & 40 & 64  & Damper pedal on / off (Sustain) & 0-127 & LSB \\
            \rowcolor{white}    01000001 & 41 & 65  & Portamento on / off & $< 63 =$  Off &  $\geq 64 =$ On \\
            \rowcolor{lightRed} 01000010 & 42 & 66  & Sustenuto on / off & $< 63 =$  Off &  $\geq 64 =$ On \\
            \rowcolor{white}    01000011 & 43 & 67  & Soft pedal on / off & $< 63 =$  Off &  $\geq 64 =$ On \\
            \rowcolor{lightRed} 01000100 & 44 & 68  & Legato Footswitch & $< 63 =$  Off &  $\geq 64 =$ On \\
            \rowcolor{white}    01000101 & 45 & 69  & Hold 2 & $< 63 =$  Off &  $\geq 64 =$ On \\
            \rowcolor{lightRed} 01000110 & 46 & 70  & Sound controller 1 (Sound Variation) & 0-127 & LSB \\
            \rowcolor{white}    01000111 & 47 & 71  & Sound controller 2 (Timbre) & 0-127 & LSB \\
            \rowcolor{lightRed} 01001000 & 48 & 72  & Sound controller 3 (Release Time) & 0-127 & LSB \\
            \rowcolor{white}    01001001 & 49 & 73  & Sound controller 4 (Attack Time) & 0-127 & LSB \\
            \rowcolor{lightRed} 01001010 & 4A & 74  & Sound controller 5 (Brightness) & 0-127 & LSB \\
            \rowcolor{white}    01001011 & 4B & 75  & Sound controller 6 & 0-127 & LSB \\
            \rowcolor{lightRed} 01001100 & 4C & 76  & Sound controller 7 & 0-127 & LSB \\
            \rowcolor{white}    01001101 & 4D & 77  & Sound controller 8 & 0-127 & LSB \\
            \rowcolor{lightRed} 01001110 & 4E & 78  & Sound controller 9 & 0-127 & LSB \\
            \rowcolor{white}    01001111 & 4F & 79  & Sound controller 10 & 0-127 & LSB \\
            \rowcolor{lightRed} 01010000 & 50 & 80  & General Controller \#5 & 0-127 & LSB \\
            \rowcolor{white}    01010001 & 51 & 81  & General Controller \#6 & 0-127 & LSB \\
            \rowcolor{lightRed} 01010010 & 52 & 82  & General Controller \#7 & 0-127 & LSB \\
            \rowcolor{white}    01010011 & 53 & 83  & General Controller \#8 & 0-127 & LSB \\
            \rowcolor{lightRed} 01010100 & 54 & 84  & Portamento Control & 0-127 & Nota de origem \\
            \rowcolor{white}    01010101 & 55 & 85  & Indefinido & 0-127 & LSB \\
            \rowcolor{lightRed} 01010110 & 56 & 86  & Indefinido & 0-127 & LSB \\
            \rowcolor{white}    01010111 & 57 & 87  & Indefinido & 0-127 & LSB \\
            \rowcolor{lightRed} 01011000 & 58 & 88  & Indefinido & 0-127 & LSB \\
            \rowcolor{white}    01011001 & 59 & 89  & Indefinido & 0-127 & LSB \\
            \rowcolor{lightRed} 01011010 & 5A & 90  & Indefinido & 0-127 & LSB \\
            \rowcolor{white}    01011011 & 5B & 91  & Reverb Send Level & 0-127 & LSB \\
            \rowcolor{lightRed} 01011100 & 5C & 92  & Effects 2 Depth & 0-127 & LSB \\
            \rowcolor{white}    01011101 & 5D & 93  & Chorus Send Level & 0-127 & LSB \\
            \rowcolor{lightRed} 01011110 & 5E & 94  & Effects 4 Depth & 0-127 & LSB \\
            \rowcolor{white}    01011111 & 5F & 95  & Effects 5 Depth & 0-127 & LSB \\
            \rowcolor{lightRed} 01100000 & 60 & 96  & Data Entry + 1 & N/A & N/A \\
            \rowcolor{white}    01100001 & 61 & 97  & Data Entry - 1 & N/A & N/A \\
            \rowcolor{lightRed} 01100010 & 62 & 98  & Non-Registered Parameter Number LSB & 0-127 & LSB \\
            \rowcolor{white}    01100011 & 63 & 99  & Non-Registered Parameter Number MSB & 0-127 & MSB \\
            \rowcolor{lightRed} 01100100 & 64 & 100 & Registered Parameter Number LSB & 0-127 & LSB \\
            \rowcolor{white}    01100101 & 65 & 101 & Registered Parameter Number MSB & 0-127 & MSB \\
            \rowcolor{lightRed} 01100110 & 66 & 102 & Indefinido & N/A & N/A \\
            \rowcolor{white}    01100111 & 67 & 103 & Indefinido & N/A & N/A \\
            \rowcolor{lightRed} 01101000 & 68 & 104 & Indefinido & N/A & N/A \\
            \rowcolor{white}    01101001 & 69 & 105 & Indefinido & N/A & N/A \\
            \rowcolor{lightRed} 01101010 & 6A & 106 & Indefinido & N/A & N/A \\
            \rowcolor{white}    01101011 & 6B & 107 & Indefinido & N/A & N/A \\
            \rowcolor{lightRed} 01101100 & 6C & 108 & Indefinido & N/A & N/A \\
            \rowcolor{white}    01101101 & 6D & 109 & Indefinido & N/A & N/A \\
            \rowcolor{lightRed} 01101110 & 6E & 110 & Indefinido & N/A & N/A \\
            \rowcolor{white}    01101111 & 6F & 111 & Indefinido & N/A & N/A \\
            \rowcolor{lightRed} 01110000 & 70 & 112 & Indefinido & N/A & N/A \\
            \rowcolor{white}    01110001 & 71 & 113 & Indefinido & N/A & N/A \\
            \rowcolor{lightRed} 01110010 & 72 & 114 & Indefinido & N/A & N/A \\
            \rowcolor{white}    01110011 & 73 & 115 & Indefinido & N/A & N/A \\
            \rowcolor{lightRed} 01110100 & 74 & 116 & Indefinido & N/A & N/A \\
            \rowcolor{white}    01110101 & 75 & 117 & Indefinido & N/A & N/A \\
            \rowcolor{lightRed} 01110110 & 76 & 118 & Indefinido & N/A & N/A \\
            \rowcolor{white}    01110111 & 77 & 119 & Indefinido & N/A & N/A \\
            \rowcolor{lightRed} 01111000 & 78 & 120 & All Sound Off & 0 & 0 \\
            \rowcolor{white}    01111001 & 79 & 121 & Reset All Controllers & 0 & 0 \\
            \rowcolor{lightRed} 01111010 & 7A & 122 & Local control on / off & 0 = Off & 127 = On \\
            \rowcolor{white}    01111011 & 7B & 123 & All notes off & 0 & 0 \\
            \rowcolor{lightRed} 01111100 & 7C & 124 & Omni mode off (+ all notes off) & 0 & 0 \\
            \rowcolor{white}    01111101 & 7D & 125 & Omni mode on (+ all notes off) & 0 & 0 \\
            \rowcolor{lightRed} 01111110 & 7E & 126 & Poly mode on / off (+ all notes off) & N/A & N/A \\
            \rowcolor{white}    01111111 & 7F & 127 & Poly mode on (incl. mono = off + all notes off) & 0 & 0 \\
        \end{supertabular}
        \end{center}

    \section{Mensagens MIDI}

        As seguintes tabelas são referências para as seguintes mensagens MIDI: mensagens de voz de canal; de modo; comuns do sistema; e em tempo real.

        No entanto, para facilitar a leitura das tabelas, será apresentada uma curta tabela descrevendo as variáveis que serão encontradas e o que elas representam (todos os valores são representados de acordo com o número de \textit{bits} esperado):

        \begin{itemize}
                \item cccc: representa o número do canal.

                \item nnnnnnn: representa o número da nota.

                \item vvvvvvv: representa o valor da velocidade.

                \item \#\#\#\#\#\#\#: representa o número para a mudança de controle.

                \item VVVVVVV: representa o valor para a mudança de controle.

                \item ppppppp: representa o valor o número do programa.

                \item PPPPPPP: representa o valor da pressão.

                \item mmmmmmm: representa o MSB.

                \item lllllll: representa o \sigla{LSB}{Least Significant Bit}.

                \item ddddddd: representa valores dos dados \sigla{SysEx}{System Exclusive}.

                \item sssssss: representa o valor da seleção de música.
        \end{itemize}

        %%%%%%%%%%%%%%%%%%%%%%%%%%%%%%%%%%%%%%%%%
        %                                       %
        %             Tabela B.10               %
        %                                       %
        %%%%%%%%%%%%%%%%%%%%%%%%%%%%%%%%%%%%%%%%%

        \begin{center}
        \tablefirsthead{%
          \hline
          \rowcolor{darkRed} \textcolor{white}{\textbf{Byte de estado}} & \textcolor{white}{\textbf{Dado (2$^\circ$ Byte)}} & \textcolor{white}{\textbf{Dado (3$^\circ$ Byte)}} & \textcolor{white}{\textbf{Descrição}} \\
          \hline}
        \tablehead{%
          \hline
          \multicolumn{4}{|l|}{\small\sl continuação da página anterior} \\
          \hline
          \rowcolor{darkRed} \textcolor{white}{\textbf{Byte de estado}} & \textcolor{white}{\textbf{Dado (2$^\circ$ Byte)}} & \textcolor{white}{\textbf{Dado (3$^\circ$ Byte)}} & \textcolor{white}{\textbf{Descrição}} \\
          \hline}
        \tabletail{%
          \hline
          \multicolumn{4}{|r|}{\small\sl continua na próxima página} \\
          \hline}
        \tablelasttail{\hline}
        \bottomcaption{Lista de mensagens de voz de canal
        \label{table:MIDI_message_channel_voice}}
        %
        \begin{supertabular}{| C{2cm} | C{2cm} | C{2.3cm} | C{8cm} |}
            \rowcolor{lightRed} 1000cccc & 0nnnnnnn & 0vvvvvvv & Note Off event: Sent when a note is released (ended). \\
            \rowcolor{white}    1001cccc & 0nnnnnnn & 0vvvvvvv & Note On event: Sent when a note is depressed (started). \\
            \rowcolor{lightRed} 1010cccc & 0nnnnnnn & 0vvvvvvv & Polyphonic Key Pressure (Aftertouch): Sent when the pressure (velocity) of a previously triggered note changes. \\
            \rowcolor{white}    1011cccc & 0\#\#\#\#\#\#\# & 0VVVVVVV & Control Change: Sent when a controller value changes. Controllers include devices such as pedals and levers. Certain controller numbers are reserved for specific purposes. \\
            \rowcolor{lightRed} 1100cccc & 0ppppppp &  & Program Change: Sent when the patch number changes. \\
            \rowcolor{white}    1101cccc & 0PPPPPPP &  & Channel Pressure (Aftertouch): Sent when the channel pressure changes. Use this to send the single greatest velocity (of all the current depressed keys). \\
            \rowcolor{lightRed} 1110cccc & 0lllllll & 0mmmmmmm & Pitch Wheel Change: Sent to indicate a change in the pitch wheel. The pitch wheel is measured by a 14-bit value. Center (no pitch change) is 2000H. Sensitivity is a function of the transmitter. \\
        \end{supertabular}
        \end{center}

        %%%%%%%%%%%%%%%%%%%%%%%%%%%%%%%%%%%%%%%%%
        %                                       %
        %             Tabela B.11               %
        %                                       %
        %%%%%%%%%%%%%%%%%%%%%%%%%%%%%%%%%%%%%%%%%

        \begin{center}
        \tablefirsthead{%
          \hline
          \rowcolor{darkRed} \textcolor{white}{\textbf{Byte de estado}} & \textcolor{white}{\textbf{Dado (2$^\circ$ Byte)}} & \textcolor{white}{\textbf{Dado (3$^\circ$ Byte)}} & \textcolor{white}{\textbf{Descrição}} \\
          \hline}
        \tablehead{%
          \hline
          \multicolumn{4}{|l|}{\small\sl continuação da página anterior} \\
          \hline
          \rowcolor{darkRed} \textcolor{white}{\textbf{Byte de estado}} & \textcolor{white}{\textbf{Dado (2$^\circ$ Byte)}} & \textcolor{white}{\textbf{Dado (3$^\circ$ Byte)}} & \textcolor{white}{\textbf{Descrição}} \\
          \hline}
        \tabletail{%
          \hline
          \multicolumn{4}{|r|}{\small\sl continua na próxima página} \\
          \hline}
        \tablelasttail{\hline}
        \bottomcaption{Lista de mensagens de modo de canal
        \label{table:MIDI_message_channel_mode}}
        %
        \begin{supertabular}{| C{2cm} | C{2cm} | C{2.3cm} | C{8cm} |}
            \rowcolor{lightRed} 1011cccc & 0\#\#\#\#\#\#\# & 0VVVVVVV & Channel Mode Messages: The same code as tab.~\ref{table:MIDI_message_channel_voice} but implements Mode control. \\
            \rowcolor{white}    1011cccc & 01111010 & 00000000 & Local Control Off: When Local Control is Off, all devices on a given channel will respond only to data received over MIDI. Played data, etc., will be ignored. 2nd Data byte = 122, 3rd Data byte at 0 = Local Control Off \\
            \rowcolor{lightRed} 1011cccc & 01111010 & 01111111 & Local Control On: This restores the functions of the normal controllers. 2nd Data byte = 122, 3rd Data byte at 127 = Local Control On  \\
            \rowcolor{white}    1011cccc & 01111011 & 00000000 & All Notes Off: When an All Notes Off is received, all oscillators will turn off. 2nd Data byte = 123, 0 = causes All Notes Off. (See text for description of actual mode commands.) \\
            \rowcolor{lightRed} 1011cccc & 01111100 & 00000000 & Omni Mode Off: 2nd Data byte = 1 24, 0 = causes All Notes Off. \\
            \rowcolor{white}    1011cccc & 01111101 & 00000000 & Omni Mode On: 2nd Data byte = 125, 0 = causes All Notes Off. \\
            \rowcolor{lightRed} 1011cccc & 00000000 & 00000000 & Mono Mode On (Poly Off): This is where M is the number of channels: 2nd Data byte = 126, v = M (also causes All Notes Off). \\
            \rowcolor{white}    1011cccc & 01111111 & 00000000 & Poly Mode On (Mono Off): 2nd Data byte = 127, 0 = also causes All Notes Off.

 \\
        \end{supertabular}
        \end{center}

        %%%%%%%%%%%%%%%%%%%%%%%%%%%%%%%%%%%%%%%%%
        %                                       %
        %             Tabela B.12               %
        %                                       %
        %%%%%%%%%%%%%%%%%%%%%%%%%%%%%%%%%%%%%%%%%

        \begin{center}
        \tablefirsthead{%
          \hline
          \rowcolor{darkRed} \textcolor{white}{\textbf{Byte de estado}} & \textcolor{white}{\textbf{Dado (2$^\circ$ Byte)}} & \textcolor{white}{\textbf{Dado (3$^\circ$ Byte)}} & \textcolor{white}{\textbf{Descrição}} \\
          \hline}
        \tablehead{%
          \hline
          \multicolumn{4}{|l|}{\small\sl continuação da página anterior} \\
          \hline
          \rowcolor{darkRed} \textcolor{white}{\textbf{Byte de estado}} & \textcolor{white}{\textbf{Dado (2$^\circ$ Byte)}} & \textcolor{white}{\textbf{Dado (3$^\circ$ Byte)}} & \textcolor{white}{\textbf{Descrição}} \\
          \hline}
        \tabletail{%
          \hline
          \multicolumn{4}{|r|}{\small\sl continua na próxima página} \\
          \hline}
        \tablelasttail{\hline}
        \bottomcaption{Lista de mensagens comuns do sistema
        \label{table:MIDI_message_channel_mode}}
        %
        \begin{supertabular}{| C{2cm} | C{2cm} | C{2.3cm} | C{8cm} |}
            \rowcolor{lightRed} 11110000 & 0iiiiiii & 0ddddddd & System Exclusive: This message makes up for all that MIDI doesn’t support. System Exclusive is used to send bulk dumps such as patch parameters and other non-spec data. (Note: real-time messages may be interleaved ONLY with a System Exclusive.) \\
            \rowcolor{white}    ... & ... & 0ddddddd & 11110111 \\
            \rowcolor{lightRed} 11110001 &  &  & Indefinido  \\
            \rowcolor{white}    11110010 & 0lllllll & 0mmmmmmm & Song Position Pointer: This is an internal 14-bit register that holds the number of MIDI beats (1 beat = six MIDI clocks) from the start of the song. \\
            \rowcolor{lightRed} 11110011 & 0sssssss &  & Song Select: The Song Select specifies which sequence or song is to be played. \\
            \rowcolor{white}    11110100 &  &  & Indefinido           \\
            \rowcolor{lightRed} 11110101 &  &  & Indefinido           \\
            \rowcolor{white}    11110110 &  &  & Tune Request: Upon receiving a Tune Request, all analog synthesizers should tune their oscillators. \\
            \rowcolor{lightRed} 11110111 &  &  & End of Exclusive: Used to terminate a System Exclusive dump. \\
        \end{supertabular}
        \end{center}

        %%%%%%%%%%%%%%%%%%%%%%%%%%%%%%%%%%%%%%%%%
        %                                       %
        %             Tabela B.13               %
        %                                       %
        %%%%%%%%%%%%%%%%%%%%%%%%%%%%%%%%%%%%%%%%%

        \begin{center}
        \tablefirsthead{%
          \hline
          \rowcolor{darkRed} \textcolor{white}{\textbf{Byte de estado}} & \textcolor{white}{\textbf{Dado (2$^\circ$ Byte)}} & \textcolor{white}{\textbf{Dado (3$^\circ$ Byte)}} & \textcolor{white}{\textbf{Descrição}} \\
          \hline}
        \tablehead{%
          \hline
          \multicolumn{4}{|l|}{\small\sl continuação da página anterior} \\
          \hline
          \rowcolor{darkRed} \textcolor{white}{\textbf{Byte de estado}} & \textcolor{white}{\textbf{Dado (2$^\circ$ Byte)}} & \textcolor{white}{\textbf{Dado (3$^\circ$ Byte)}} & \textcolor{white}{\textbf{Descrição}} \\
          \hline}
        \tabletail{%
          \hline
          \multicolumn{4}{|r|}{\small\sl continua na próxima página} \\
          \hline}
        \tablelasttail{\hline}
        \bottomcaption{Lista de mensagens em tempo real
        \label{table:MIDI_message_channel_mode}}
        %
        \begin{supertabular}{| C{2cm} | C{2cm} | C{2.3cm} | C{8cm} |}
            \rowcolor{lightRed} 11111000 &  &  & Timing Clock: Sent 24 times per quarter note when synchronization is required. \\
            \rowcolor{white}    11111001 &  &  & Indefinido \\
            \rowcolor{lightRed} 11111010 &  &  & Start: Start the current sequence playing. (This message will be followed with timing clocks.) \\
            \rowcolor{white}    11111011 &  &  & Continue: Continue at the point the sequence was stopped. \\
            \rowcolor{lightRed} 11111100 &  &  & Stop: Stop the current sequence. \\
            \rowcolor{white}    11111101 &  &  & Indefinido           \\
            \rowcolor{lightRed} 11111110 &  &  & Active Sensing: When initially sent, the receiver will expect to receive another Active Sensing message each 300 ms (max), or it will assume that the connection has been terminated. \\
            \rowcolor{white}    11111111 &  &  & Reset: Reset all receivers in the system to power-up status. This should be used sparingly, preferably under manual control. In particular, it should not be sent on power-up. \\
        \end{supertabular}
        \end{center}
