LeoWPereira/Dalle-Pad/LaTeX Project/Conclusao.tex

%%
%% Conclusao.tex
%% Projeto Oficinas de Integração 3
%% Created by Leonardo Winter Pereira and Lucas Zimmermann Cordeiro on 10.03.2016
%% Copyright (C). All rights reserved
%%

\chapter{Considerações Finais}
\label{chap:consideracoesFinais} 

    \section{Sugestões para trabalhos futuros}
