LeoWPereira/Dalle-Pad/Datasheets/LED package dimension.gif

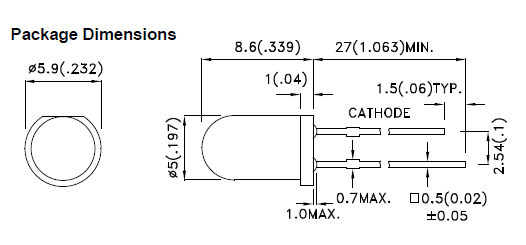
Datasheets/LED package dimension.gif
