LeoWPereira/Dalle-Pad/LaTeX Project/Imagens/changeeffect.png

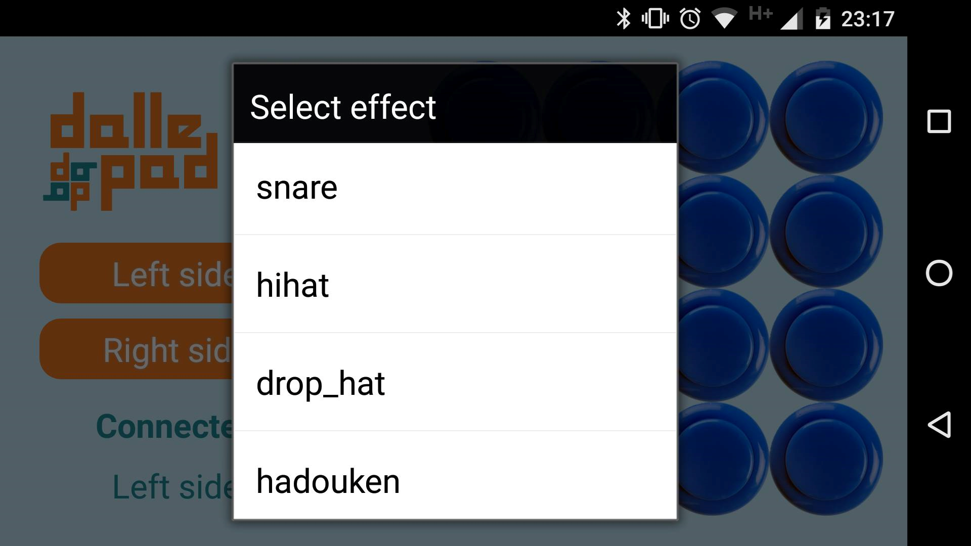
LaTeX Project/Imagens/changeeffect.png
