LeoWPereira/Dalle-Pad/LaTeX Project/Imagens/custos.JPG

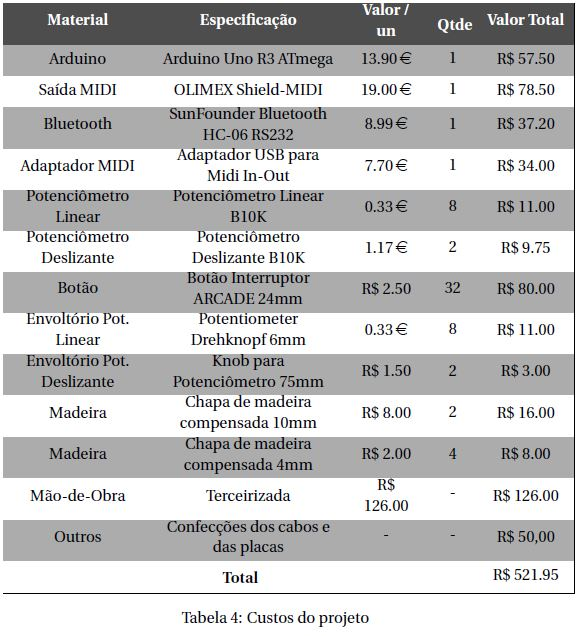
LaTeX Project/Imagens/custos.JPG
