LeoWPereira/Dalle-Pad/LaTeX Project/Imagens/DallePad360.JPG

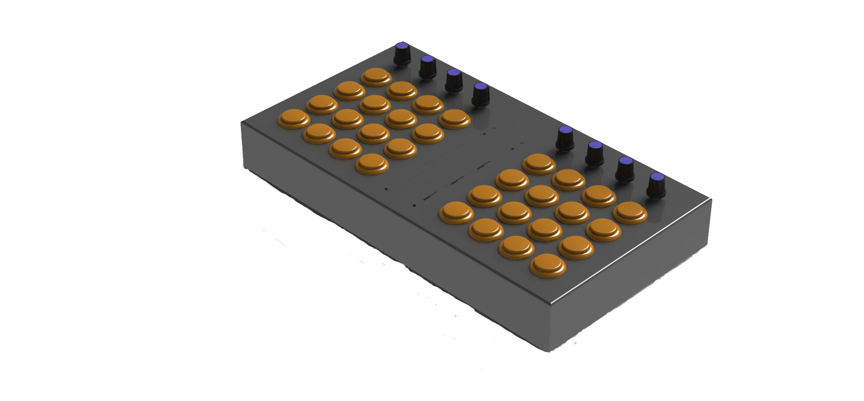
LaTeX Project/Imagens/DallePad360.JPG
