LeoWPereira/Dalle-Pad/LaTeX Project/Imagens/Equipe.png

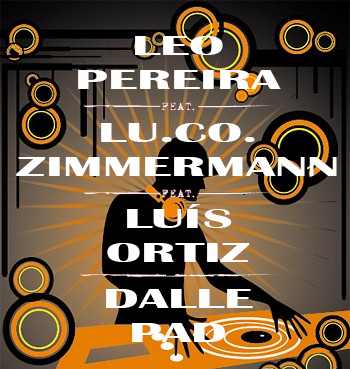
LaTeX Project/Imagens/Equipe.png
