LeoWPereira/Dalle-Pad/LaTeX Project/Imagens/Ideia_de_projeto/MIDI.png

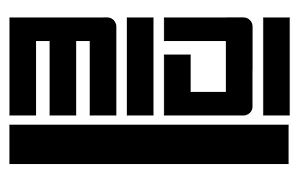
LaTeX Project/Imagens/Ideia_de_projeto/MIDI.png
