LeoWPereira/Dalle-Pad/LaTeX Project/Imagens/Imagens de Desenvolvimento/13054645_1021345867931169_1707552863_o.jpg

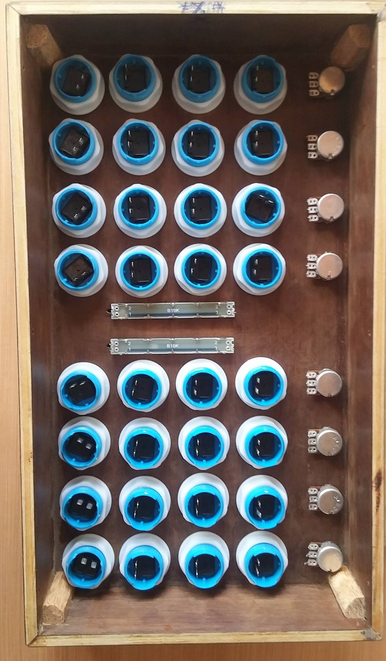
LaTeX Project/Imagens/Imagens de Desenvolvimento/13054645_1021345867931169_1707552863_o.jpg
