LeoWPereira/Dalle-Pad/LaTeX Project/Imagens/Imagens de Desenvolvimento/13161297_1027905403941882_1792344083_o.jpg

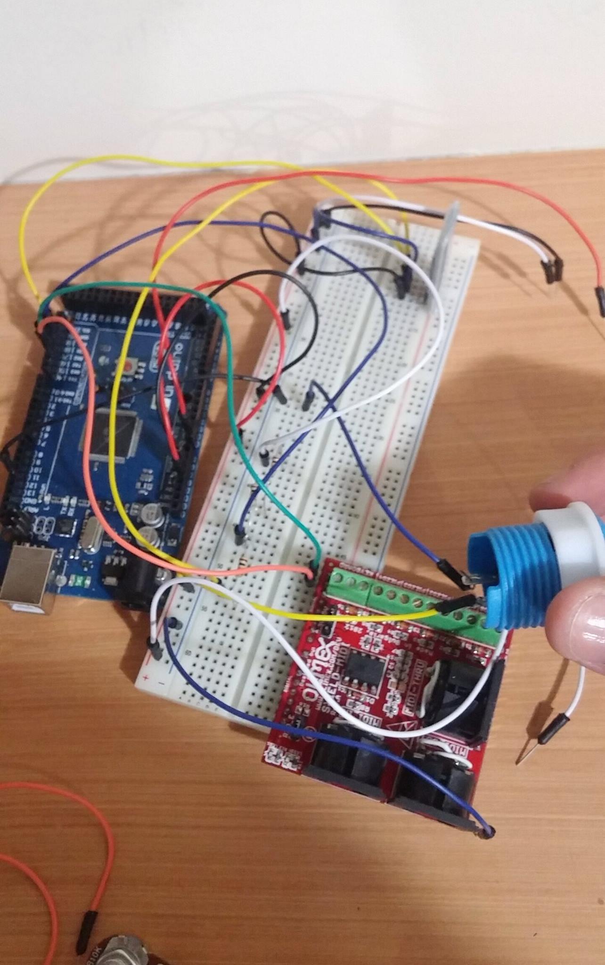
LaTeX Project/Imagens/Imagens de Desenvolvimento/13161297_1027905403941882_1792344083_o.jpg
