LeoWPereira/Dalle-Pad/LaTeX Project/Imagens/Imagens de Desenvolvimento/13161399_1027906393941783_2020927198_o.jpg

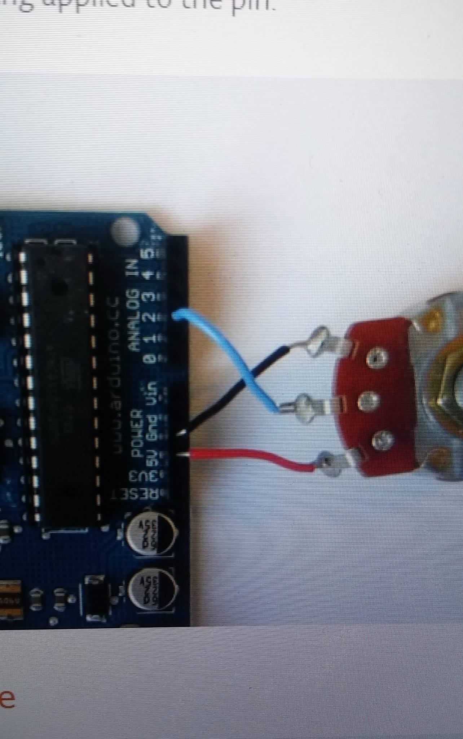
LaTeX Project/Imagens/Imagens de Desenvolvimento/13161399_1027906393941783_2020927198_o.jpg
