LeoWPereira/Dalle-Pad/LaTeX Project/Imagens/Imagens de Desenvolvimento/13275331_1040425706023185_307519982_o.jpg

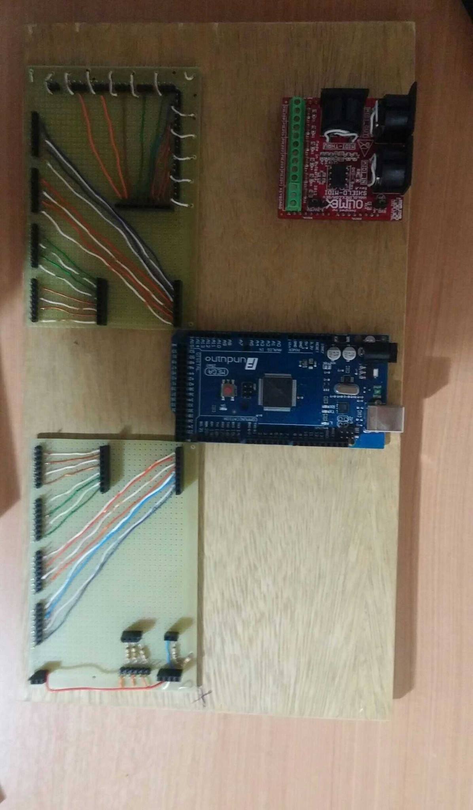
LaTeX Project/Imagens/Imagens de Desenvolvimento/13275331_1040425706023185_307519982_o.jpg
