LeoWPereira/Dalle-Pad/LaTeX Project/Imagens/requisitos.JPG

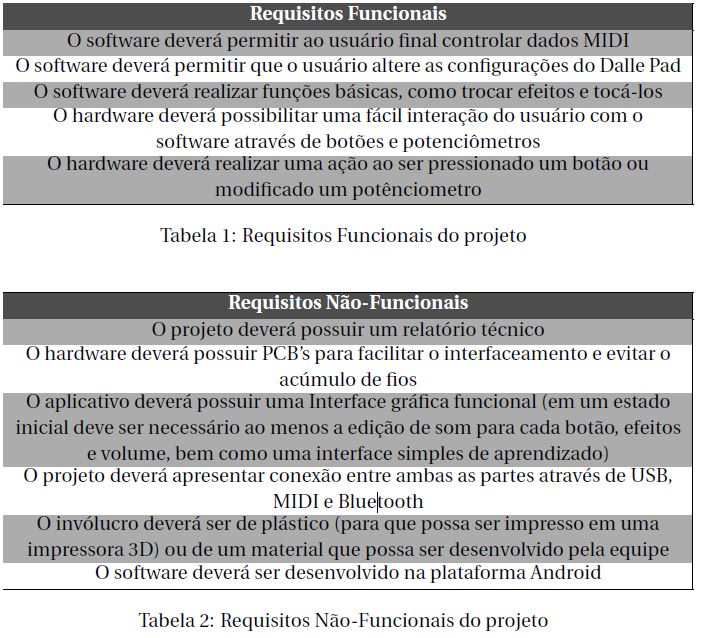
LaTeX Project/Imagens/requisitos.JPG
