LeoWPereira/Dalle-Pad/LaTeX Project/Imagens/SW_Images/Arduino Mega 2560.png

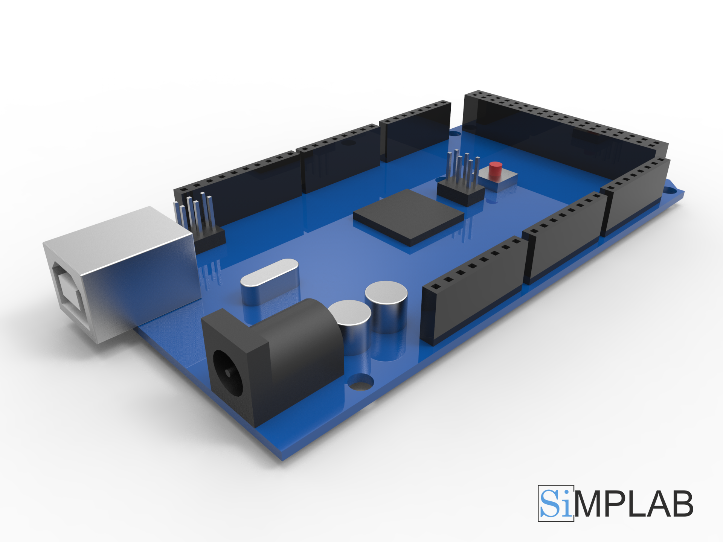
LaTeX Project/Imagens/SW_Images/Arduino Mega 2560.png
