LeoWPereira/Dalle-Pad/LaTeX Project/Imagens/SW_Images/dalle_pad_montado4.png

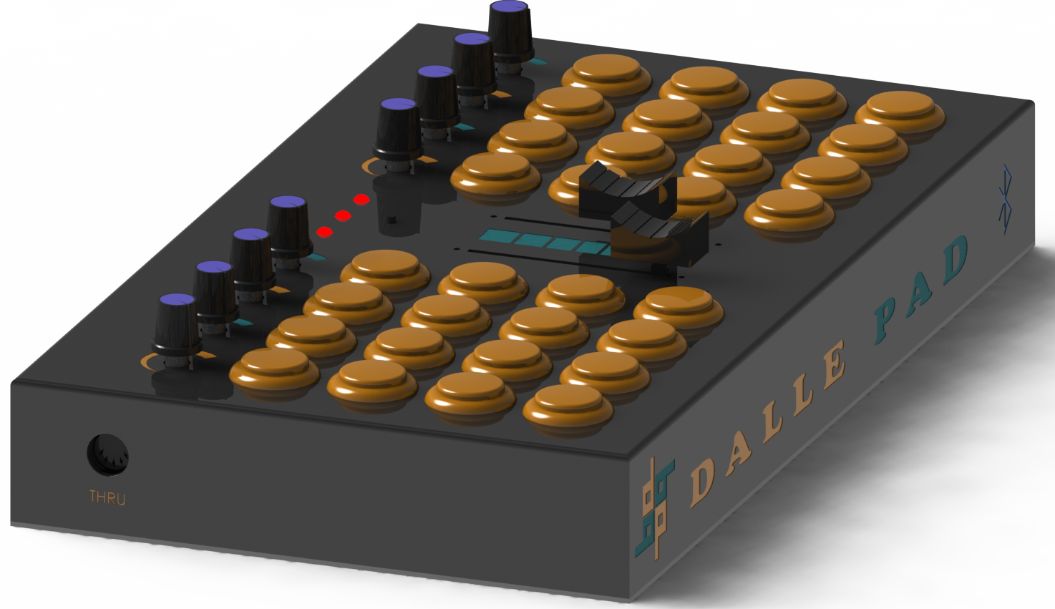
LaTeX Project/Imagens/SW_Images/dalle_pad_montado4.png
