LeoWPereira/Dalle-Pad/LaTeX Project/Imagens/SW_Images/dalle_pad_montado10.png

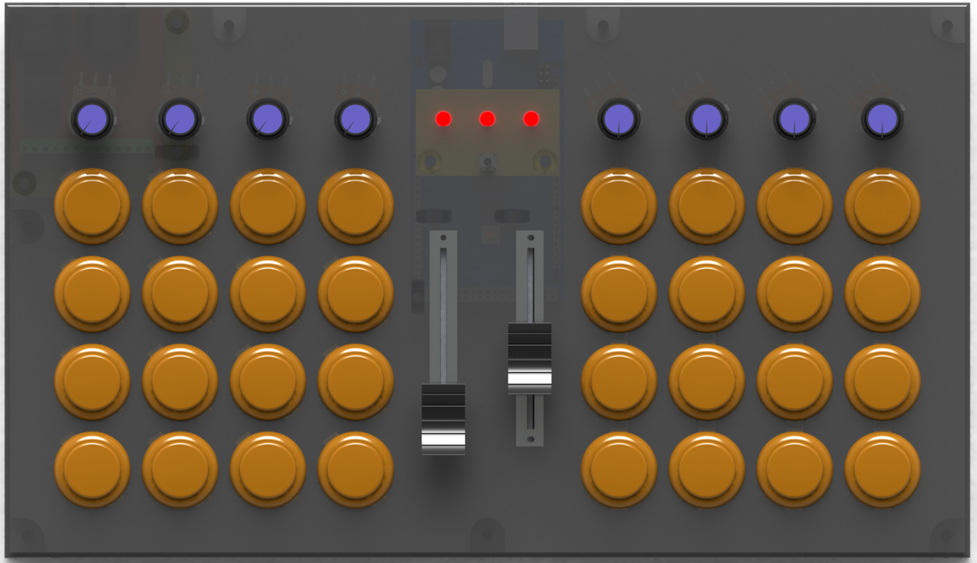
LaTeX Project/Imagens/SW_Images/dalle_pad_montado10.png
