LeoWPereira/Dalle-Pad/LaTeX Project/Imagens/SW_Images/dalle_pad_montado10_1.png

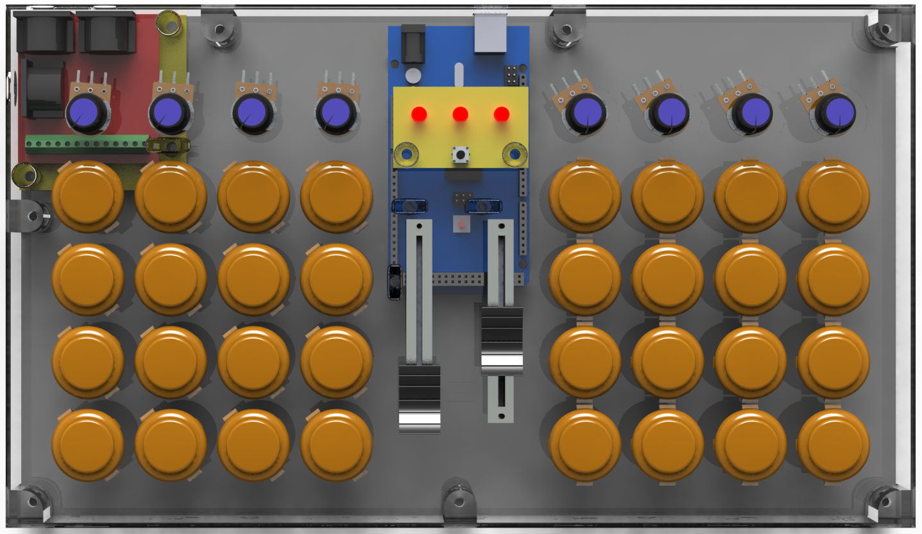
LaTeX Project/Imagens/SW_Images/dalle_pad_montado10_1.png
