LeoWPereira/Dalle-Pad/LaTeX Project/Imagens/SW_Images/dalle_pad_montado11_glass.png

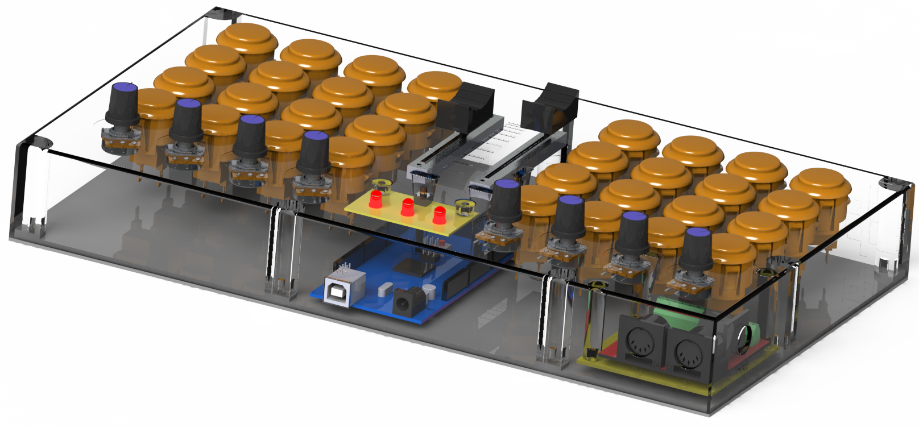
LaTeX Project/Imagens/SW_Images/dalle_pad_montado11_glass.png
