LeoWPereira/Dalle-Pad/LaTeX Project/Imagens/SW_Images/Involucro-de-Madeira/madeira3.png

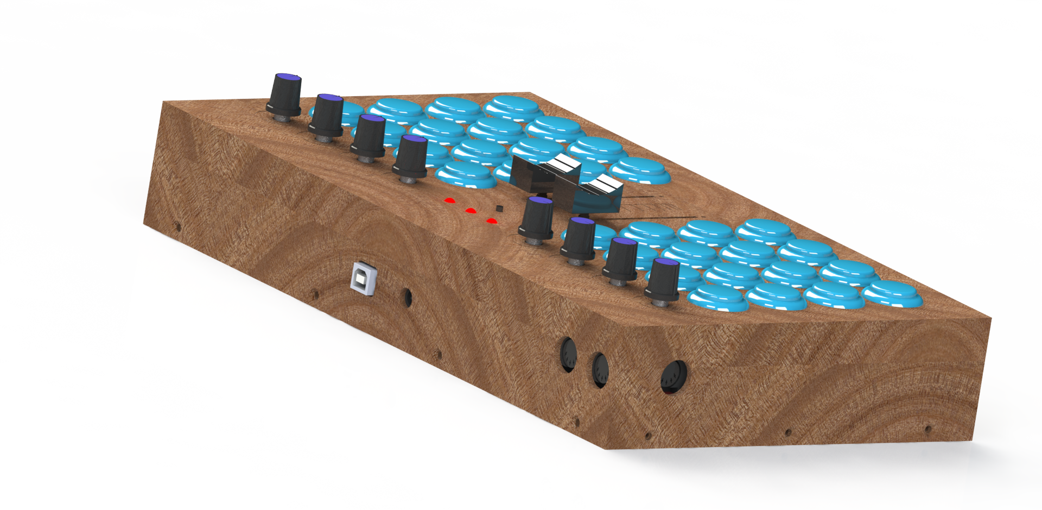
LaTeX Project/Imagens/SW_Images/Involucro-de-Madeira/madeira3.png
