LeoWPereira/Dalle-Pad/LaTeX Project/Imagens/SW_Images/Involucro-de-Madeira/madeira4.png

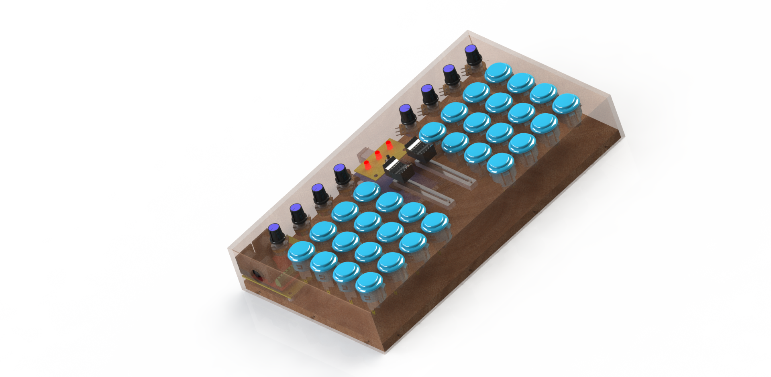
LaTeX Project/Imagens/SW_Images/Involucro-de-Madeira/madeira4.png
