LeoWPereira/Dalle-Pad/LaTeX Project/Imagens/SW_Images/PU.png

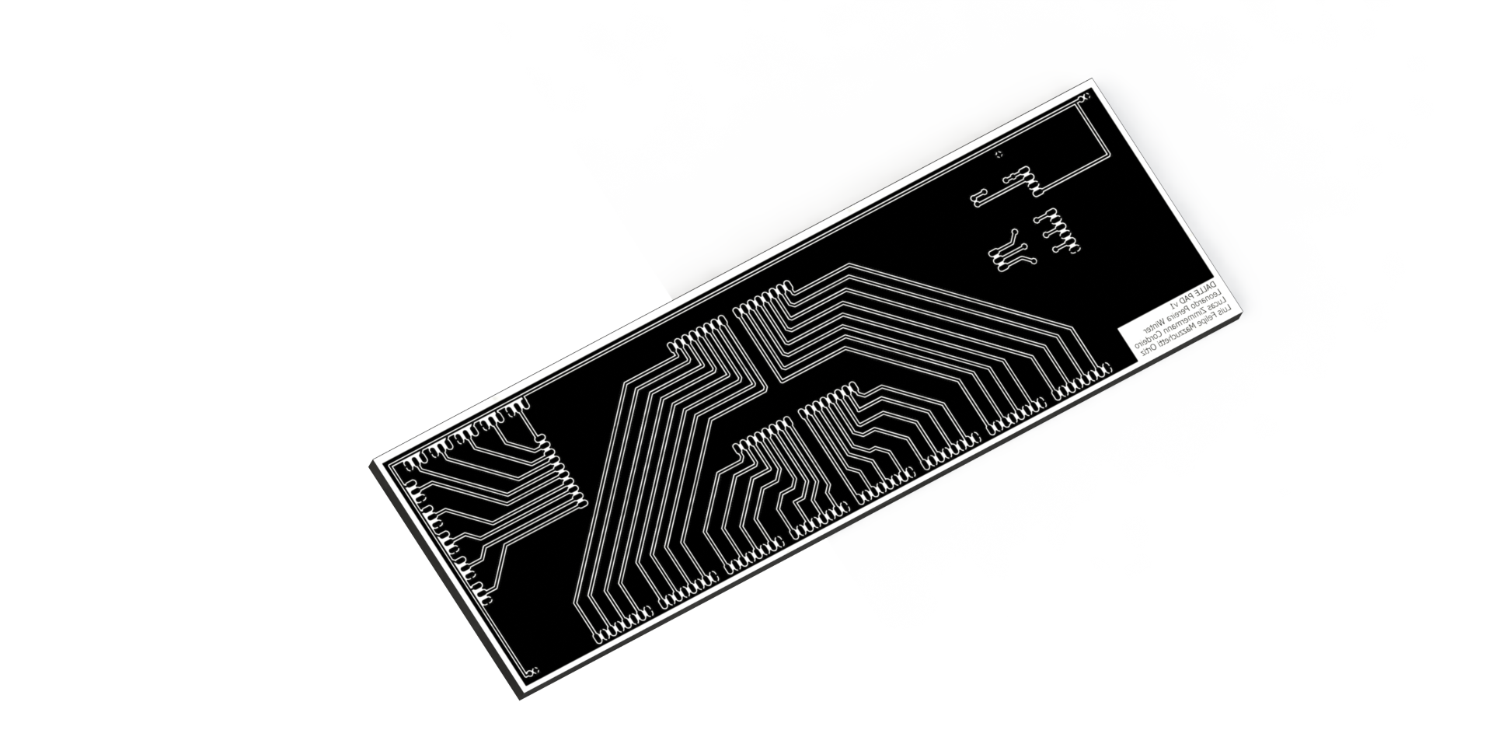
LaTeX Project/Imagens/SW_Images/PU.png
