LeoWPereira/Dalle-Pad/LaTeX Project/Imagens/Typical-MIDI-System.jpg

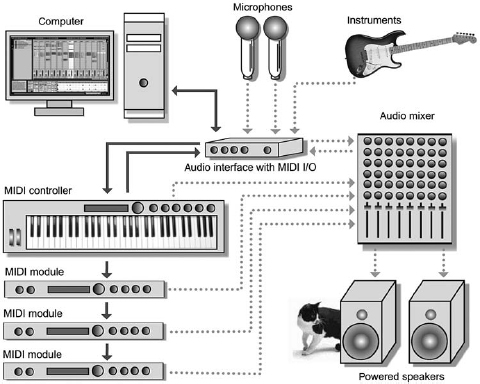
LaTeX Project/Imagens/Typical-MIDI-System.jpg
