LeoWPereira/Dalle-Pad/LaTeX Project/LaTeX Article/1st.png

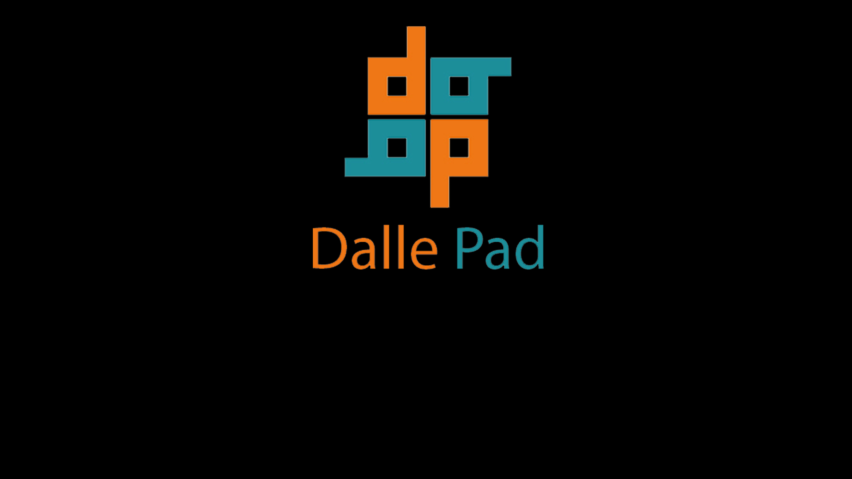
LaTeX Project/LaTeX Article/1st.png
