LeoWPereira/Dalle-Pad/LaTeX Project/LaTeX Article/2nd.png

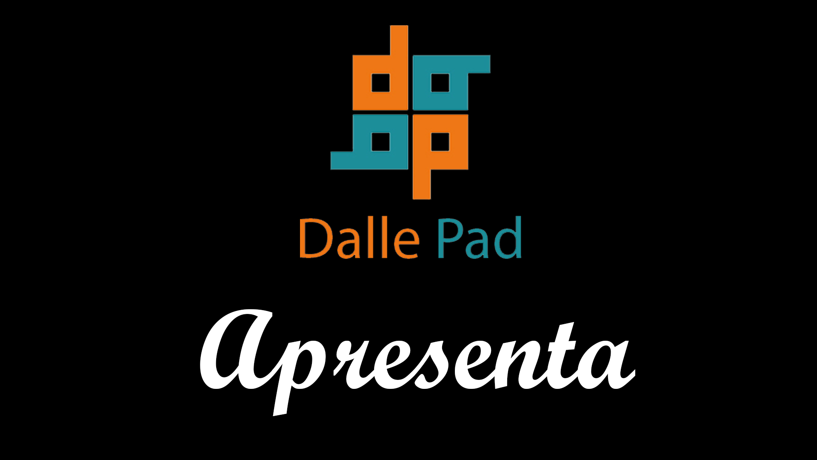
LaTeX Project/LaTeX Article/2nd.png
