LeoWPereira/Dalle-Pad/LaTeX Project/LaTeX Article/3rd.png

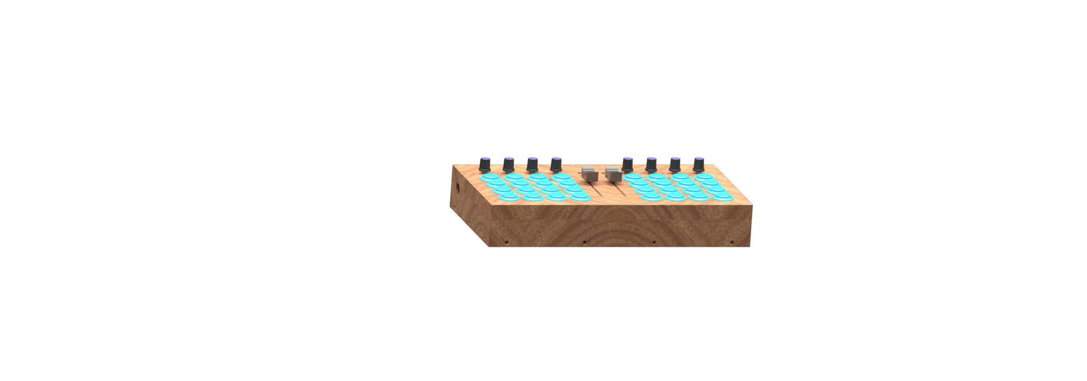
LaTeX Project/LaTeX Article/3rd.png
