LeoWPereira/Dalle-Pad/LaTeX Project/LaTeX Article/4th.png

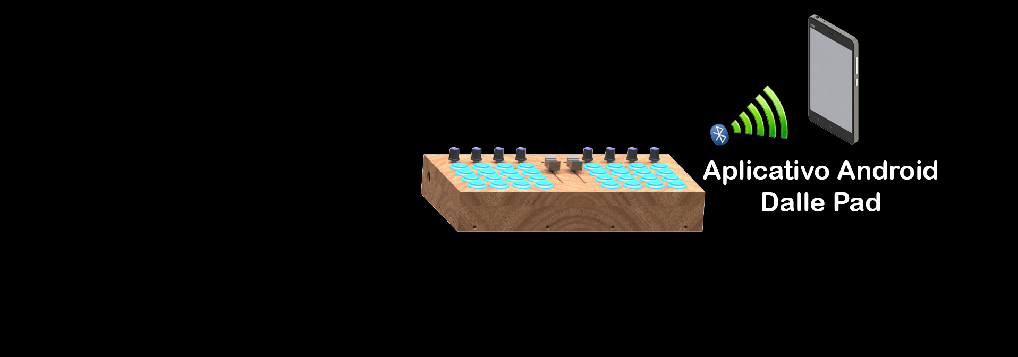
LaTeX Project/LaTeX Article/4th.png
