LeoWPereira/Dalle-Pad/LaTeX Project/LaTeX Article/5th.png

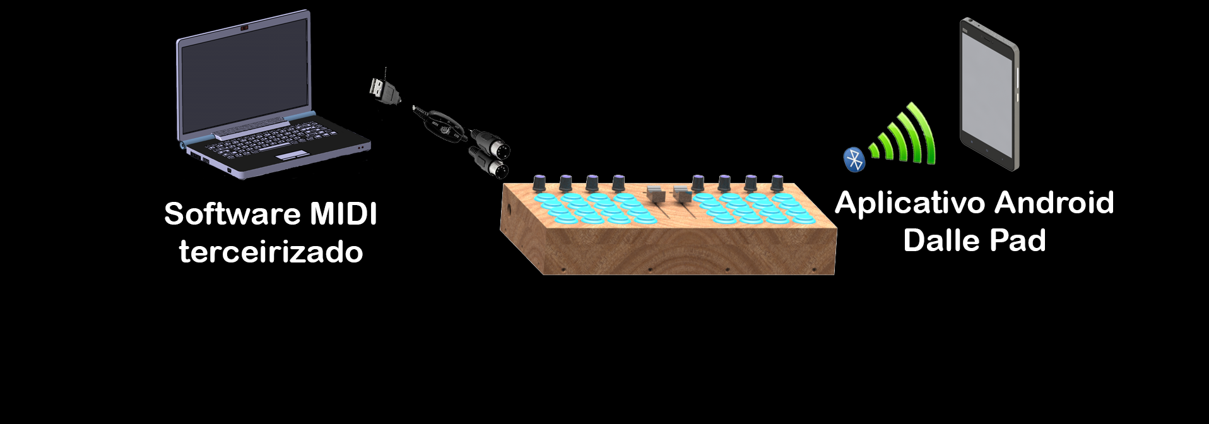
LaTeX Project/LaTeX Article/5th.png
