LeoWPereira/Dalle-Pad/LaTeX Project/LaTeX Article/Imagens/x01.png

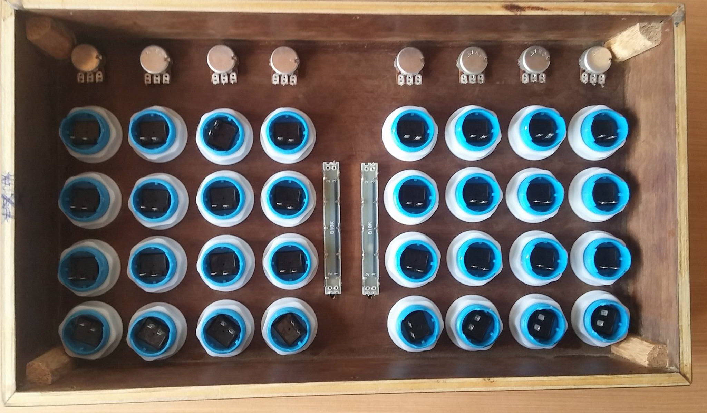
LaTeX Project/LaTeX Article/Imagens/x01.png
