LeoWPereira/Dalle-Pad/LaTeX Project/LaTeX Article/Imagens/x02.jpg

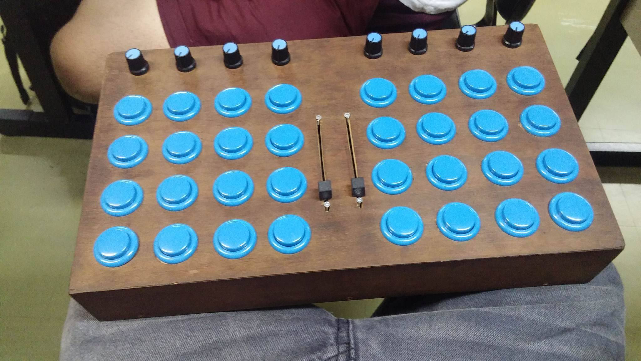
LaTeX Project/LaTeX Article/Imagens/x02.jpg
