LeoWPereira/Dalle-Pad/LaTeX Project/LaTeX Article/Imagens/x03.jpg

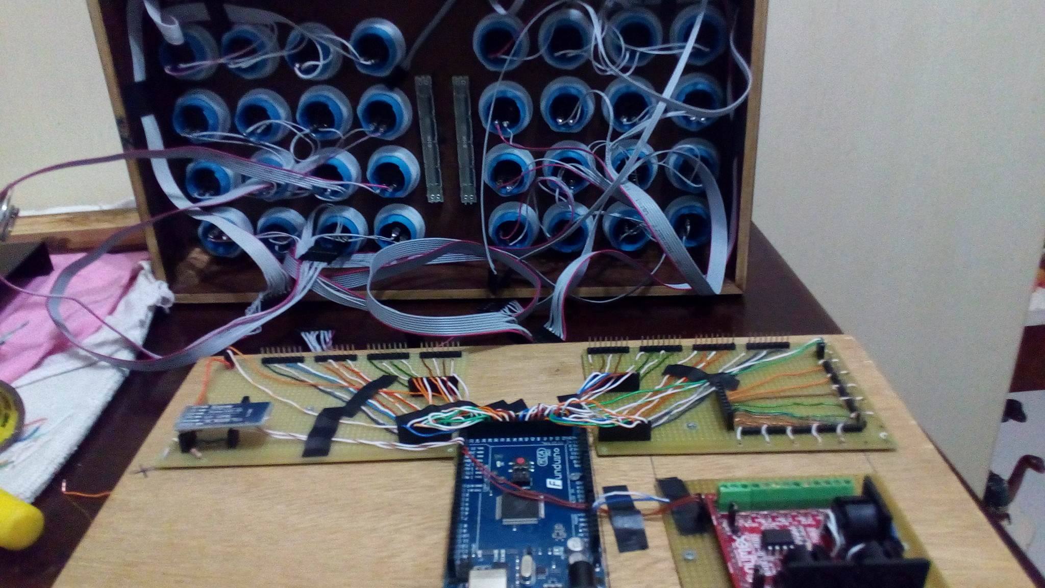
LaTeX Project/LaTeX Article/Imagens/x03.jpg
