LeoWPereira/Dalle-Pad/LaTeX Project/LaTeX Article/smartphone.png

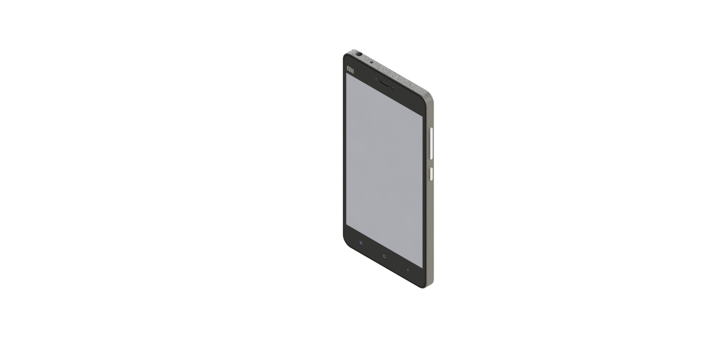
LaTeX Project/LaTeX Article/smartphone.png
