LeoWPereira/Dalle-Pad/SolidWorks Project/arcade-button-sanwa-obsf-30-g.snapshot.2/Renderings/sanwa_arcade.jpg

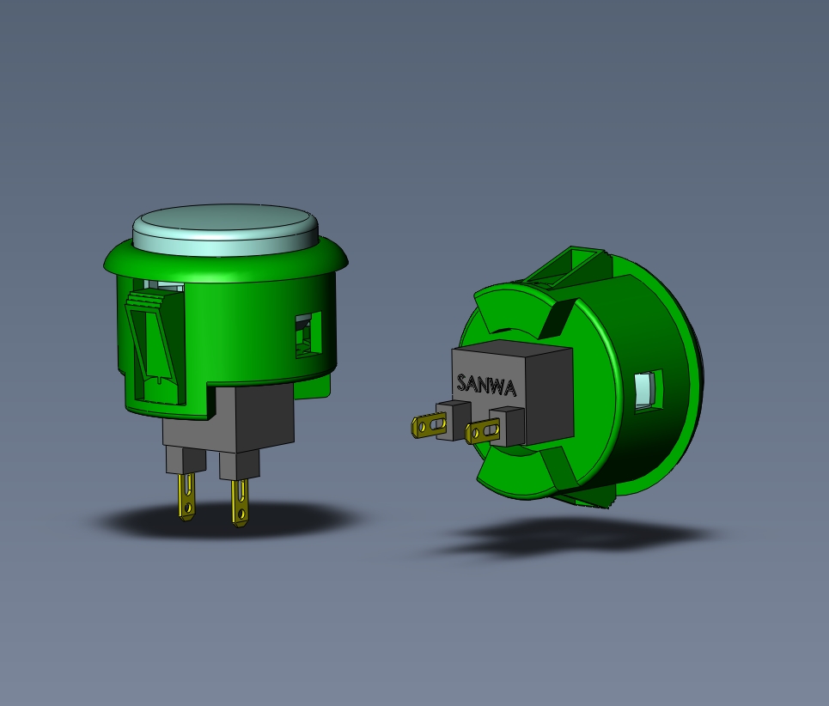
SolidWorks Project/arcade-button-sanwa-obsf-30-g.snapshot.2/Renderings/sanwa_arcade.jpg
