LeoWPereira/Dalle-Pad/SolidWorks Project/lap-top-3.snapshot.2/Renderings/1.PNG

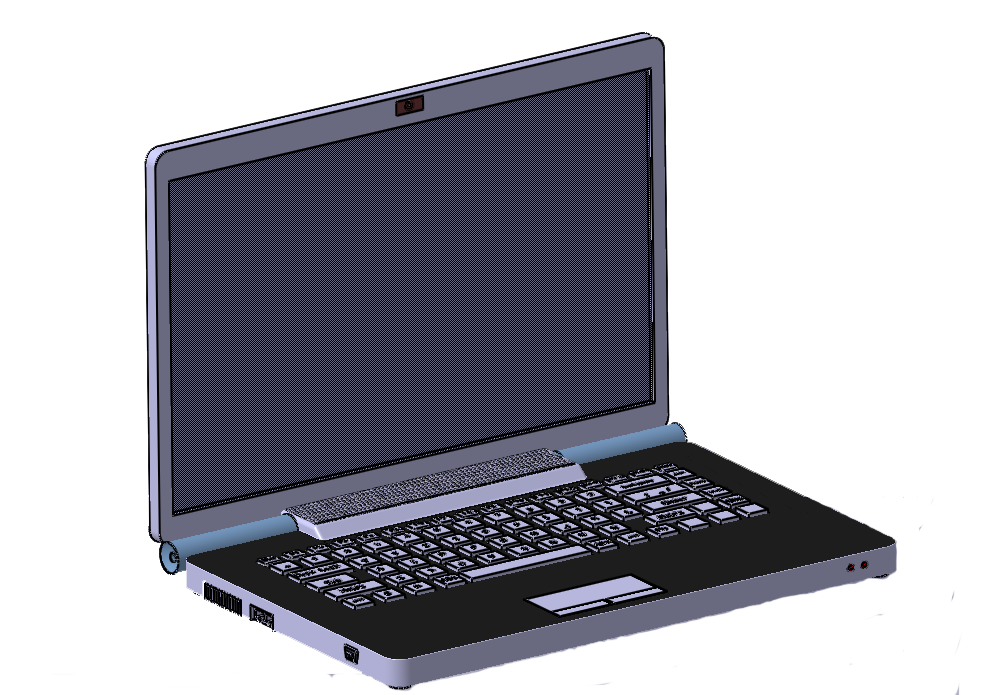
SolidWorks Project/lap-top-3.snapshot.2/Renderings/1.PNG
