LeoWPereira/Dalle-Pad/SolidWorks Project/lap-top-3.snapshot.2/Renderings/2.PNG

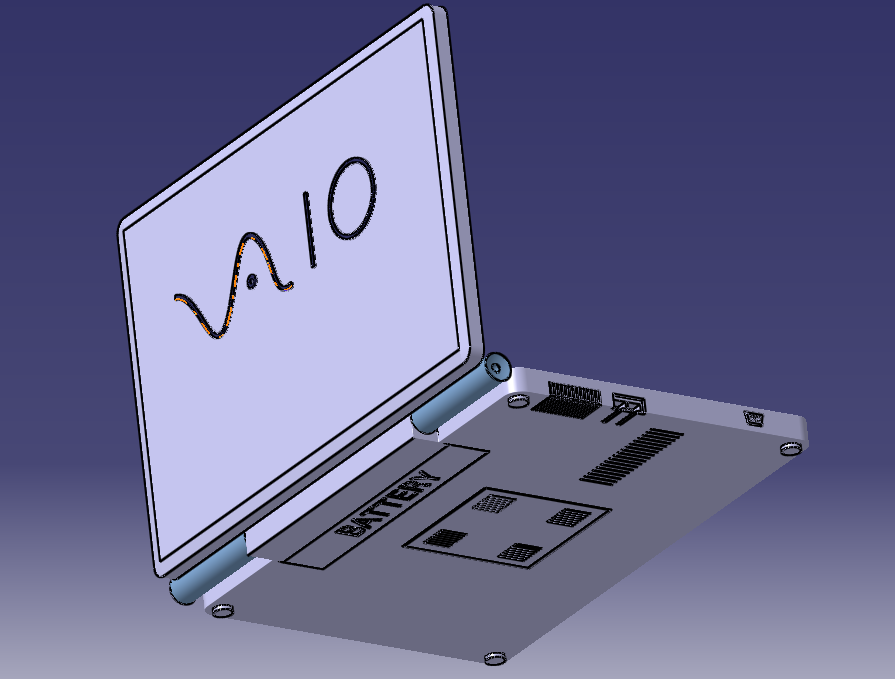
SolidWorks Project/lap-top-3.snapshot.2/Renderings/2.PNG
