LeoWPereira/Dalle-Pad/SolidWorks Project/LED/ScreenHunter_81 Dec. 30 15.29.jpg

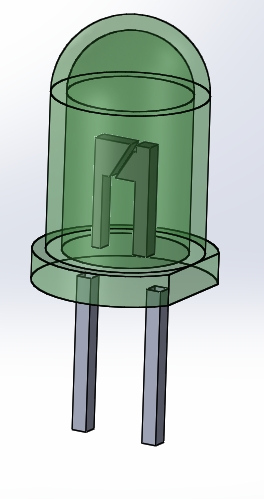
SolidWorks Project/LED/ScreenHunter_81 Dec. 30 15.29.jpg
