LeoWPereira/Dalle-Pad/SolidWorks Project/potentiometer-10k-1.snapshot.3/potentiometer 10k 2.JPG

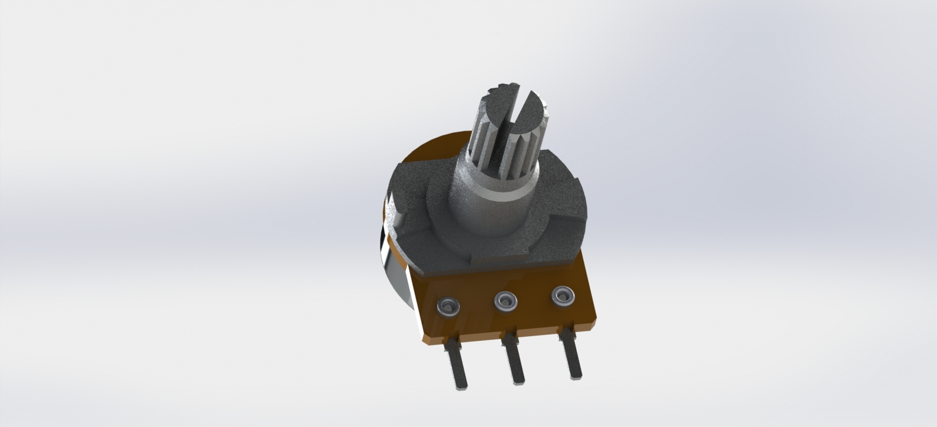
SolidWorks Project/potentiometer-10k-1.snapshot.3/potentiometer 10k 2.JPG
