LeoWPereira/Dalle-Pad/SolidWorks Project/resistor-1-4-w/Renderings/Resistor.JPG

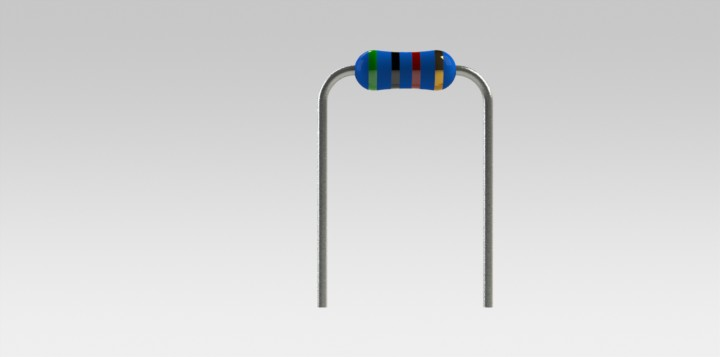
SolidWorks Project/resistor-1-4-w/Renderings/Resistor.JPG
