LeoWPereira/Dalle-Pad/SolidWorks Project/resistor-1-4-w/Renderings/Resistor_color_code_table.jpg

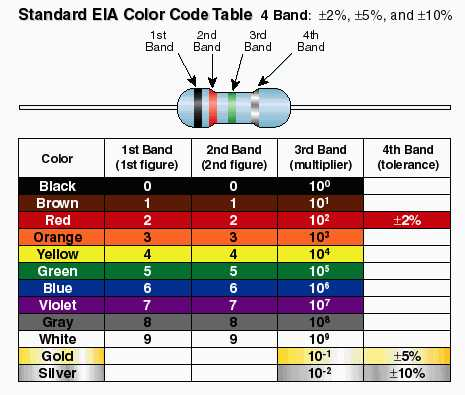
SolidWorks Project/resistor-1-4-w/Renderings/Resistor_color_code_table.jpg
