LeoWPereira/Dalle-Pad/SolidWorks Project/xiaomi-mi4c-1.snapshot.2/11. Xiaomi Mi4c 3Gb-32Gb-preview.jpg

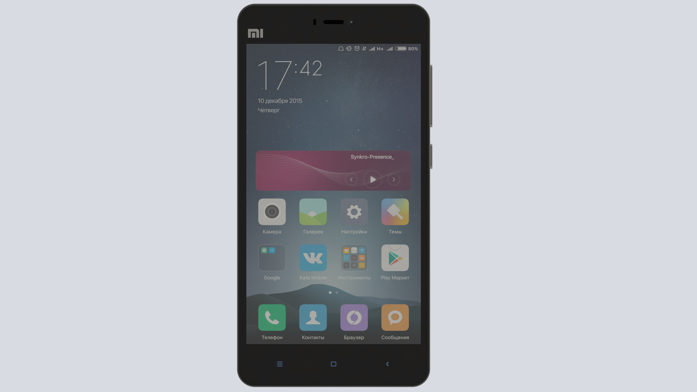
SolidWorks Project/xiaomi-mi4c-1.snapshot.2/11. Xiaomi Mi4c 3Gb-32Gb-preview.jpg
