LeoWPereira/Dalle-Pad/superior.png

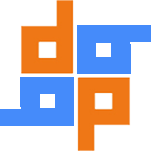
superior.png
