LeoWPereira/Dalle-Pad/SolidWorks Project/Dalle Pad/Impresso Grande/Produto_final.SLDASM

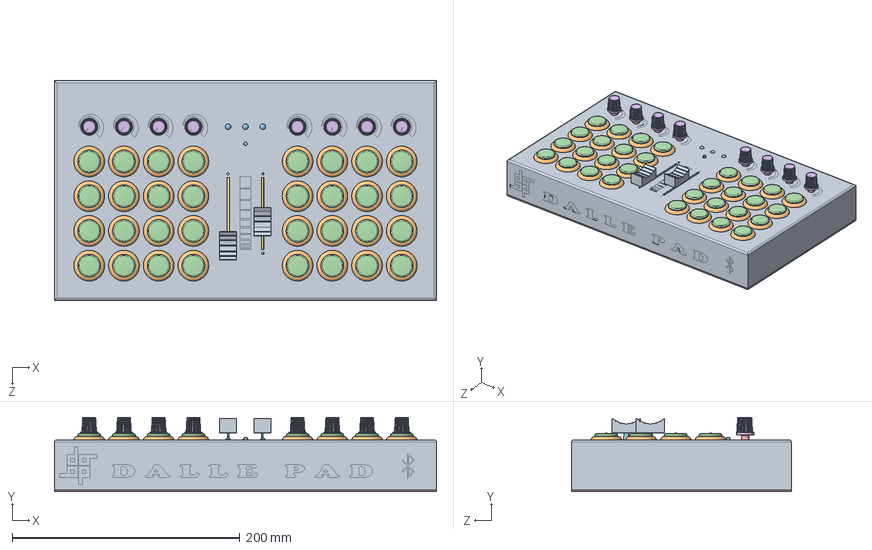
[picture p128: CAD file, 2016-06-20]
SolidWorks Project/Dalle Pad/Impresso Grande/Produto_final.SLDASM
335.5 x 65.1 x 193.0 mm
Capa Superior
base x 32
microswitch x 32
top_cap x 32
POTENTIOMETER x 8
bouton potentiomètre x 8
Pino do pot x 2
Camisinha do pino x 2
Placa pcb universal
led x 3
Botao push pull
Capa inferior
Arduino Mega 2560
MIDI SHIELD
PCB Mini Shield
