LeoWPereira/Dalle-Pad/SolidWorks Project/PCB montada/PCB montada.SLDASM

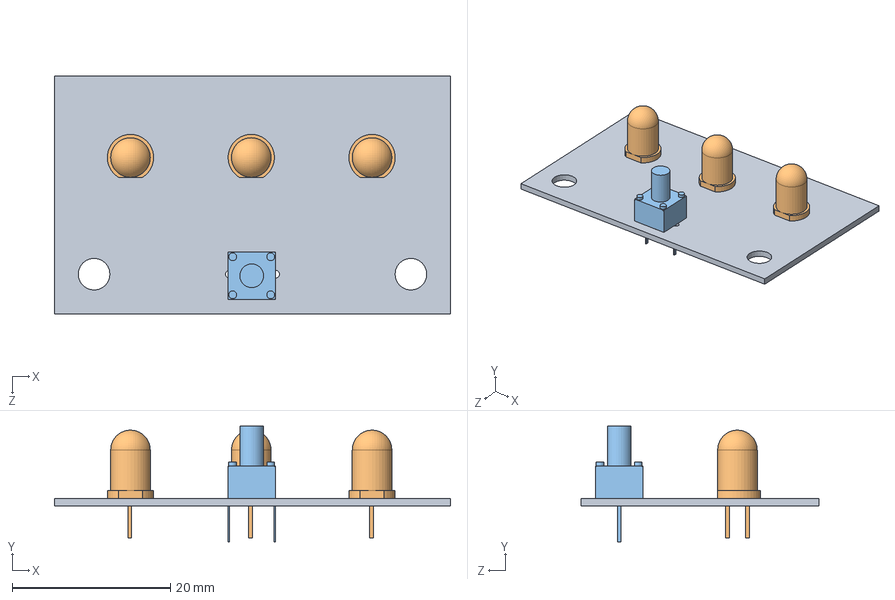
[picture p129: CAD file, 2016-06-20]
SolidWorks Project/PCB montada/PCB montada.SLDASM
50.0 x 14.6 x 30.0 mm
Placa pcb universal
led x 3
Botao push pull
