LeoWPereira/Dalle-Pad/SolidWorks Project/potentiometer-10k-1.snapshot.3/potentiometer.SLDASM

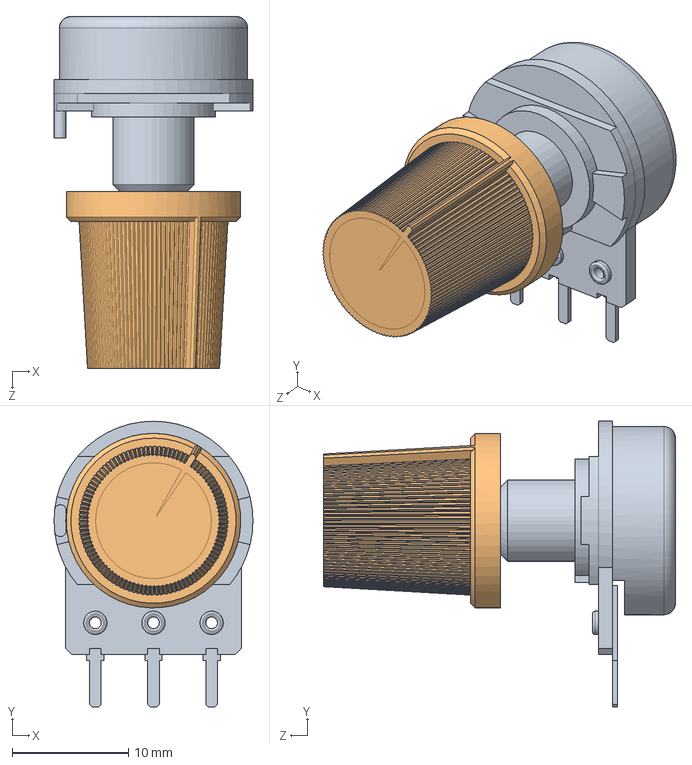
[picture p130: CAD file, 2016-06-20]
SolidWorks Project/potentiometer-10k-1.snapshot.3/potentiometer.SLDASM
17.1 x 24.6 x 30.3 mm
POTENTIOMETER
bouton potentiomètre
