LeoWPereira/Dalle-Pad/SolidWorks Project/arcade-button-sanwa-obsf-30-g.snapshot.2/!sanwa_button.SLDASM

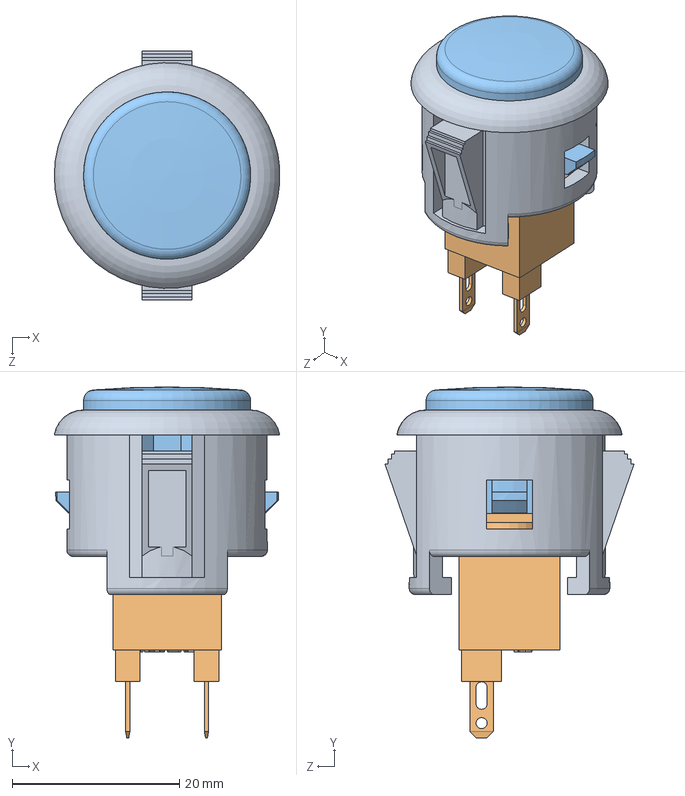
[picture p131: CAD file, 2016-06-20]
SolidWorks Project/arcade-button-sanwa-obsf-30-g.snapshot.2/!sanwa_button.SLDASM
27.0 x 42.0 x 29.8 mm
base
microswitch
top_cap
