LeoWPereira/Dalle-Pad/SolidWorks Project/B10K pot/Montagem pot.SLDASM

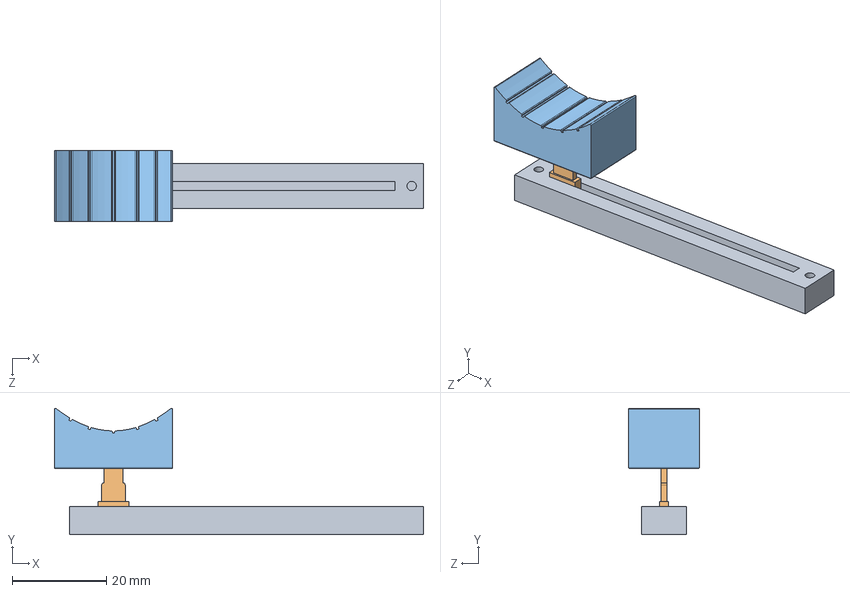
[picture p132: CAD file, 2016-06-20]
SolidWorks Project/B10K pot/Montagem pot.SLDASM
78.2 x 26.8 x 15.0 mm
Pino do pot
Camisinha do pino
