LeoWPereira/Dalle-Pad/SolidWorks Project/arcade-button-sanwa-obsf-30-g.snapshot.2/base.SLDPRT

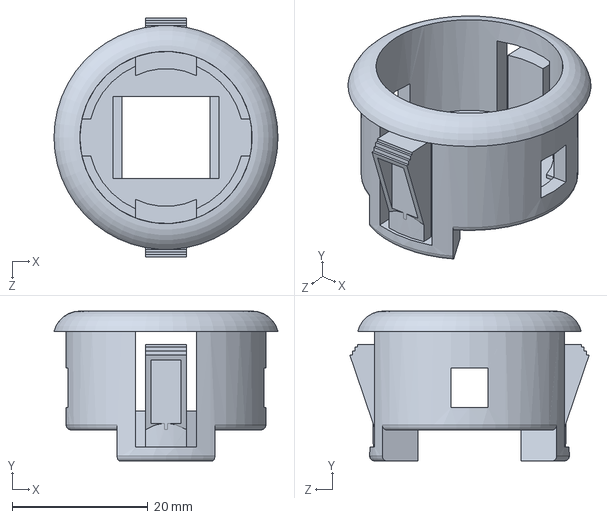
[picture p133: CAD file, 2016-06-20]
SolidWorks Project/arcade-button-sanwa-obsf-30-g.snapshot.2/base.SLDPRT
33.0 x 22.1 x 35.3 mm
