LeoWPereira/Dalle-Pad/SolidWorks Project/arduinomega-1.snapshot.2/Espassador 5.SLDPRT

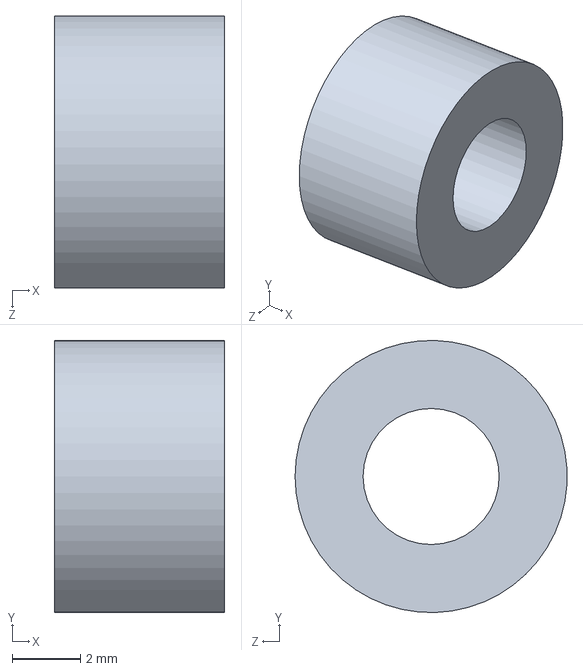
[picture p134: CAD file, 2016-06-20]
SolidWorks Project/arduinomega-1.snapshot.2/Espassador 5.SLDPRT
5.00 x 8.00 x 7.99 mm
