LeoWPereira/Dalle-Pad/SolidWorks Project/B10K pot/Pino do pot.SLDPRT

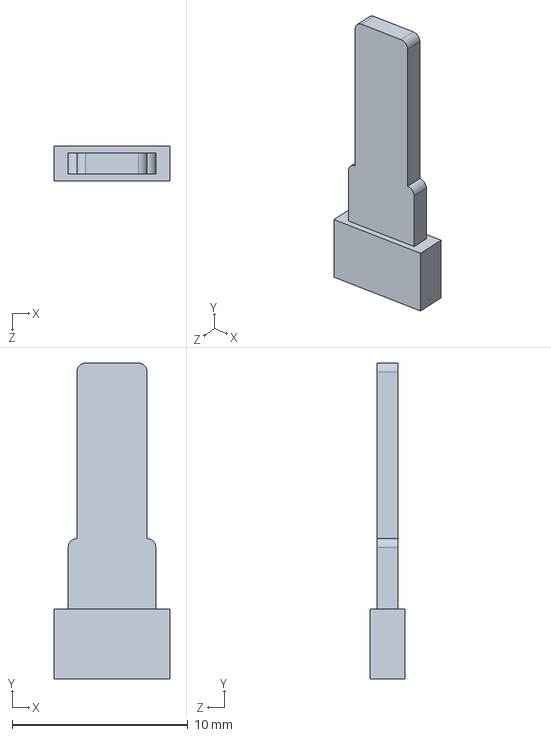
[picture p135: CAD file, 2016-06-20]
SolidWorks Project/B10K pot/Pino do pot.SLDPRT
6.60 x 18.0 x 2.00 mm
