LeoWPereira/Dalle-Pad/SolidWorks Project/Dalle Pad/Botao push pull.SLDPRT

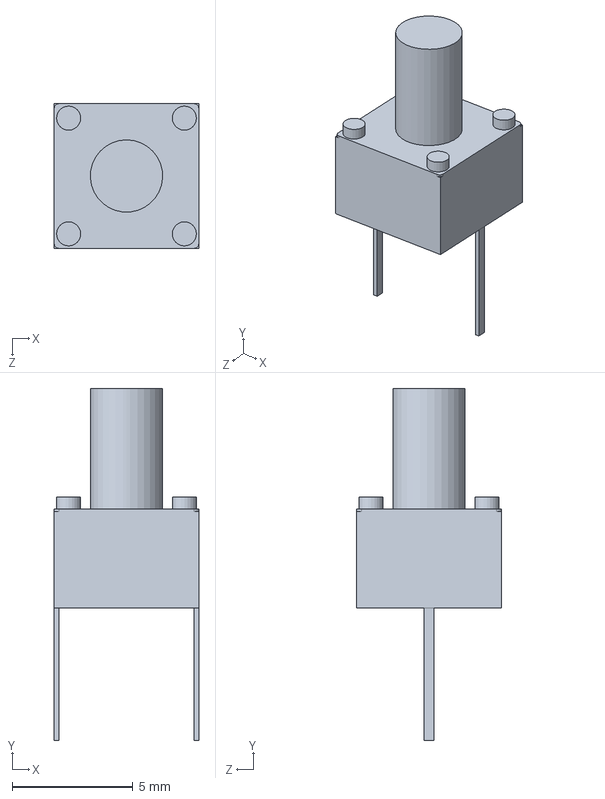
[picture p136: CAD file, 2016-06-20]
SolidWorks Project/Dalle Pad/Botao push pull.SLDPRT
6.00 x 14.6 x 6.00 mm
