LeoWPereira/Dalle-Pad/SolidWorks Project/LED/Placa pcb universal.SLDPRT

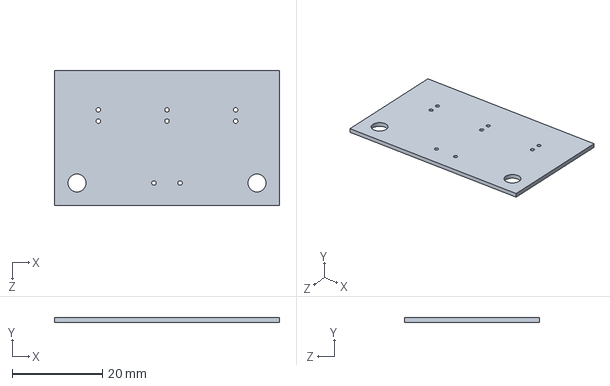
[picture p137: CAD file, 2016-06-20]
SolidWorks Project/LED/Placa pcb universal.SLDPRT
50.0 x 1.00 x 30.0 mm
