LeoWPereira/Dalle-Pad/SolidWorks Project/resistor-1-4-w/Resistor.SLDPRT

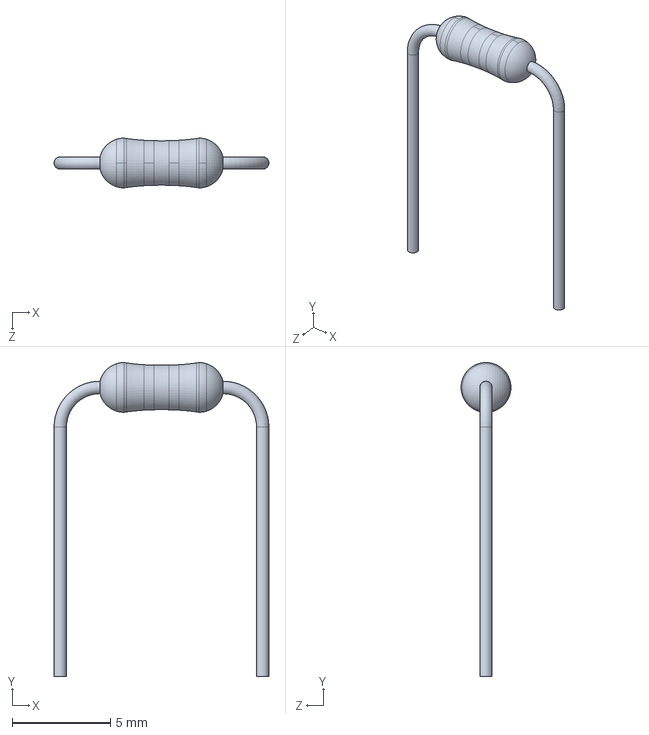
[picture p138: CAD file, 2016-06-20]
SolidWorks Project/resistor-1-4-w/Resistor.SLDPRT
10.9 x 16.0 x 2.54 mm
