LeoWPereira/Dalle-Pad/SolidWorks Project/arcade-button-sanwa-obsf-30-g.snapshot.2/top_cap.SLDPRT

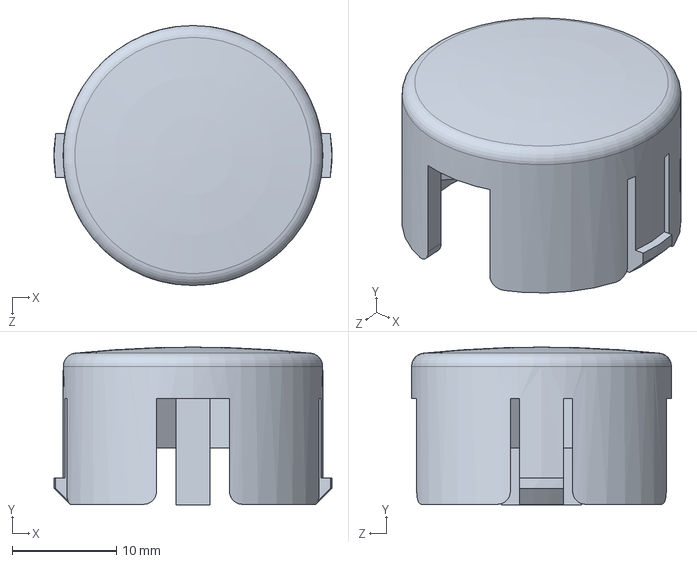
[picture p139: CAD file, 2016-06-20]
SolidWorks Project/arcade-button-sanwa-obsf-30-g.snapshot.2/top_cap.SLDPRT
26.7 x 15.1 x 24.9 mm
