LeoWPereira/Dalle-Pad/SolidWorks Project/arduinomega-1.snapshot.2/Arduino Mega 2560.STEP

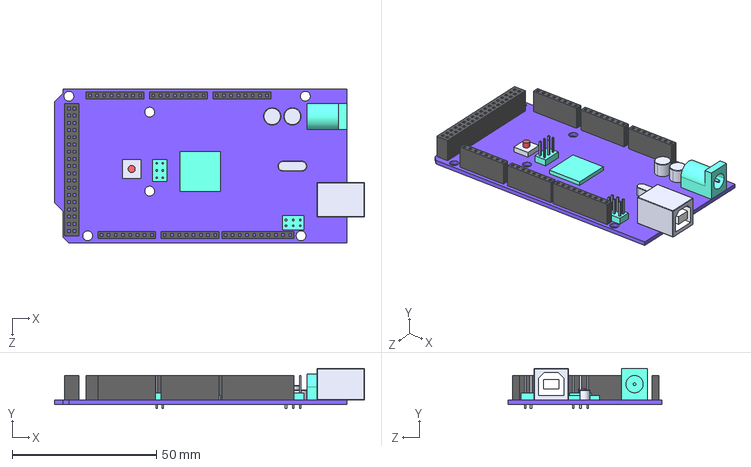
[picture p140: CAD file, 2016-06-20]
SolidWorks Project/arduinomega-1.snapshot.2/Arduino Mega 2560.STEP
107.5 x 14.0 x 53.4 mm
