LeoWPereira/Dalle-Pad/SolidWorks Project/B10K pot/Part1.SLDPRT

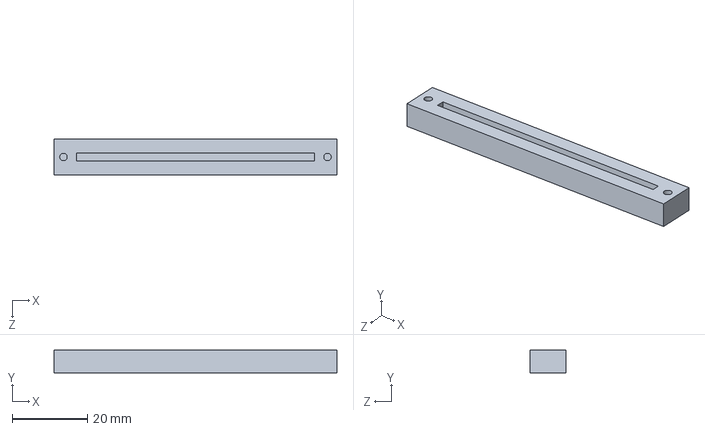
[picture p141: CAD file, 2016-06-20]
SolidWorks Project/B10K pot/Part1.SLDPRT
75.0 x 6.00 x 9.50 mm
