LeoWPereira/Dalle-Pad/SolidWorks Project/Dalle Pad/espassador 55.SLDPRT

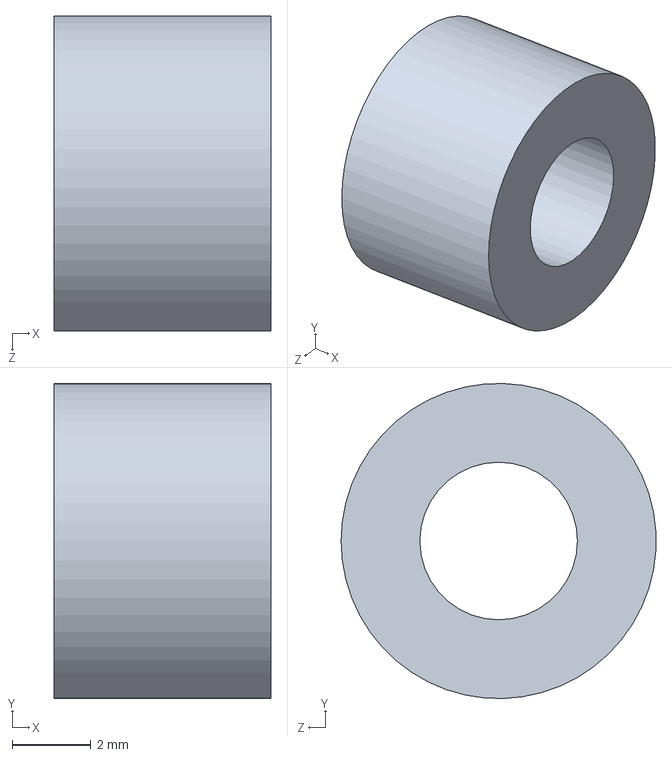
[picture p142: CAD file, 2016-06-20]
SolidWorks Project/Dalle Pad/espassador 55.SLDPRT
5.50 x 8.00 x 7.99 mm
