LeoWPereira/Dalle-Pad/SolidWorks Project/Dalle Pad/Impresso Grande/Capa Superior.SLDPRT

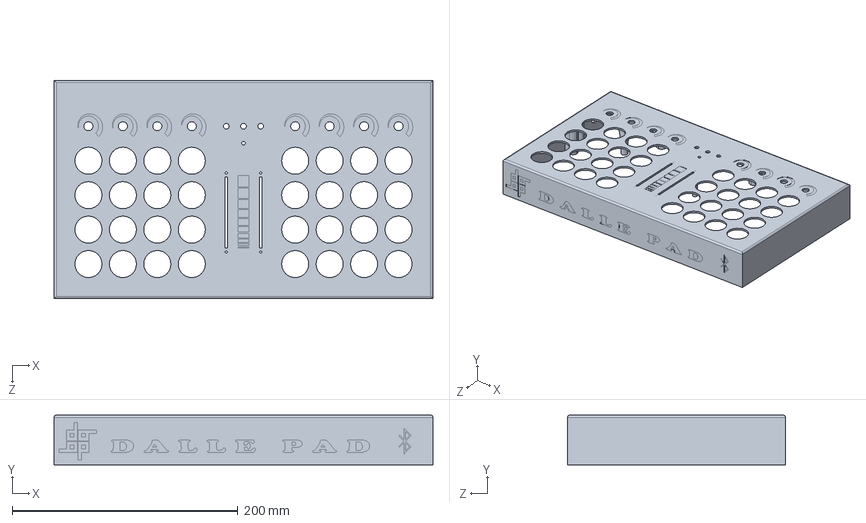
[picture p143: CAD file, 2016-06-20]
SolidWorks Project/Dalle Pad/Impresso Grande/Capa Superior.SLDPRT
335.5 x 44.0 x 193.0 mm
