LeoWPereira/Dalle-Pad/SolidWorks Project/Dalle Pad/madeira/Capa inferior.SLDPRT

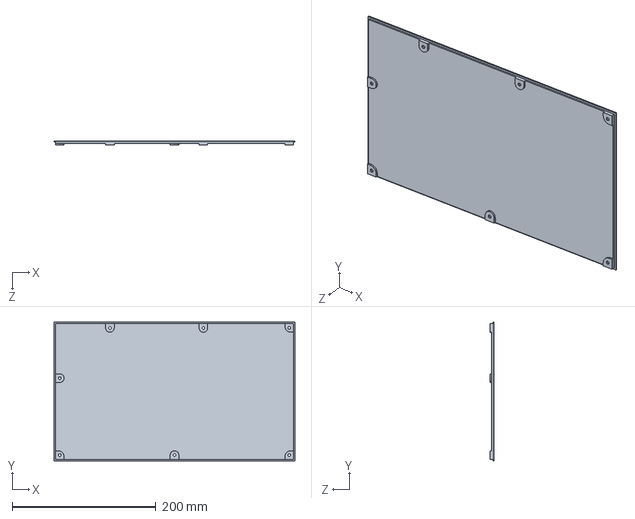
[picture p144: CAD file, 2016-06-20]
SolidWorks Project/Dalle Pad/madeira/Capa inferior.SLDPRT
335.5 x 193.0 x 5.50 mm
