LeoWPereira/Dalle-Pad/SolidWorks Project/LED/led.SLDPRT

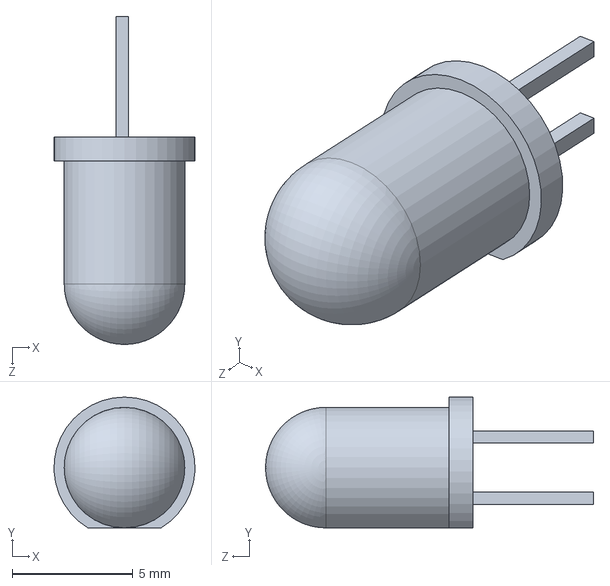
[picture p145: CAD file, 2016-06-20]
SolidWorks Project/LED/led.SLDPRT
5.84 x 5.42 x 13.6 mm
