LeoWPereira/Dalle-Pad/SolidWorks Project/B10K pot/Camisinha do pino.SLDPRT

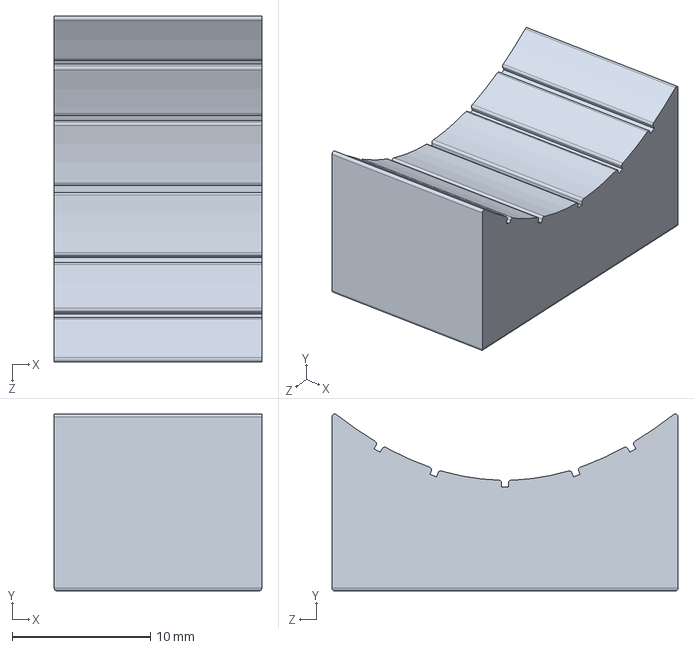
[picture p146: CAD file, 2016-06-20]
SolidWorks Project/B10K pot/Camisinha do pino.SLDPRT
15.0 x 12.8 x 25.0 mm
