LeoWPereira/Dalle-Pad/SolidWorks Project/Dalle Pad/madeira/Placa pcb universal.SLDPRT

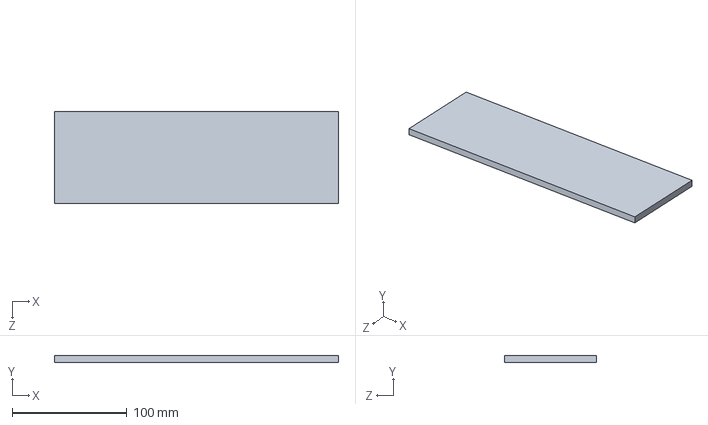
[picture p147: CAD file, 2016-06-20]
SolidWorks Project/Dalle Pad/madeira/Placa pcb universal.SLDPRT
247.0 x 6.00 x 80.0 mm
