LeoWPereira/Dalle-Pad/SolidWorks Project/Dalle Pad/PCB Mini Shield.SLDPRT

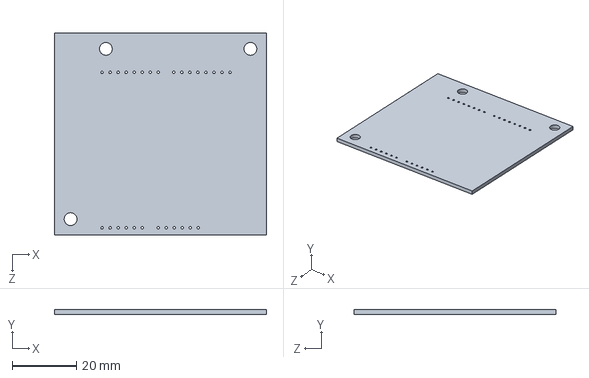
[picture p148: CAD file, 2016-06-20]
SolidWorks Project/Dalle Pad/PCB Mini Shield.SLDPRT
66.0 x 1.50 x 63.0 mm
