LeoWPereira/Dalle-Pad/SolidWorks Project/potentiometer-10k-1.snapshot.3/bouton potentiomètre.SLDPRT

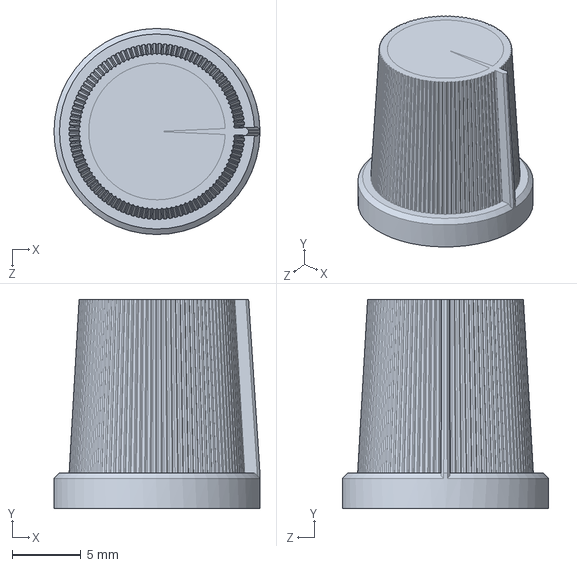
[picture p149: CAD file, 2016-06-20]
SolidWorks Project/potentiometer-10k-1.snapshot.3/bouton potentiomètre.SLDPRT
15.0 x 15.2 x 15.0 mm
