LeoWPereira/Dalle-Pad/SolidWorks Project/arcade-button-sanwa-obsf-30-g.snapshot.2/microswitch.SLDPRT

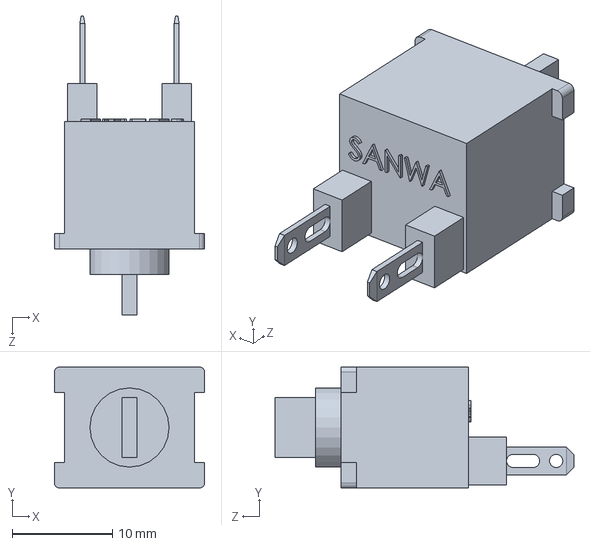
[picture p150: CAD file, 2016-06-20]
SolidWorks Project/arcade-button-sanwa-obsf-30-g.snapshot.2/microswitch.SLDPRT
15.0 x 12.1 x 29.8 mm
