LeoWPereira/Dalle-Pad/SolidWorks Project/Dalle Pad/madeira/Capa esquerda.SLDPRT

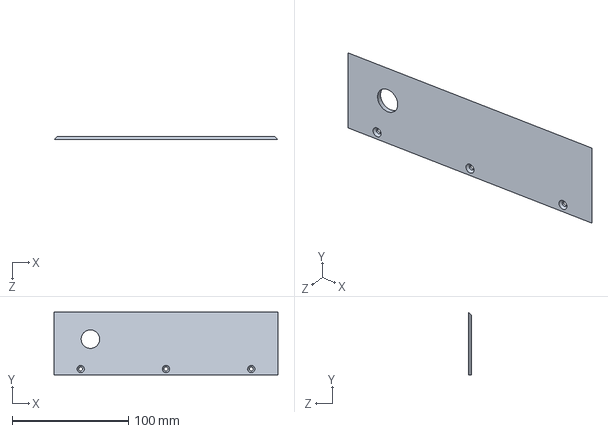
[picture p151: CAD file, 2016-06-20]
SolidWorks Project/Dalle Pad/madeira/Capa esquerda.SLDPRT
193.0 x 54.0 x 3.00 mm
