LeoWPereira/Dalle-Pad/SolidWorks Project/Dalle Pad/MIDI SHIELD.SLDPRT

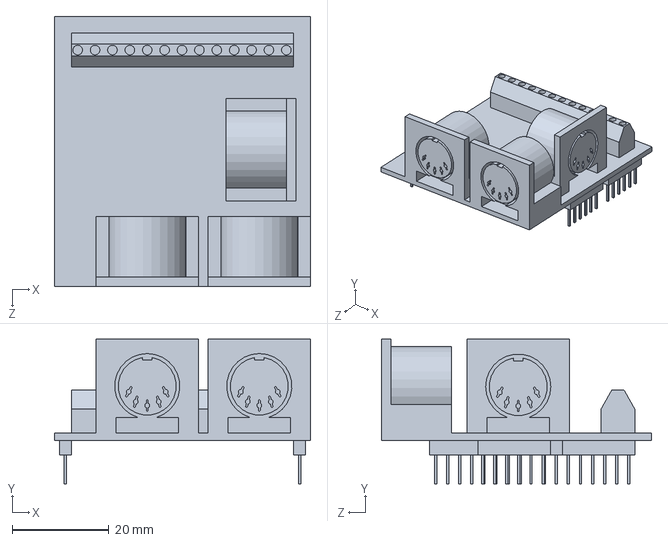
[picture p152: CAD file, 2016-06-20]
SolidWorks Project/Dalle Pad/MIDI SHIELD.SLDPRT
53.0 x 30.0 x 56.0 mm
