LeoWPereira/Dalle-Pad/SolidWorks Project/arcade-button-sanwa-obsf-30-g.snapshot.2/sanwa obsf-30-g.STEP

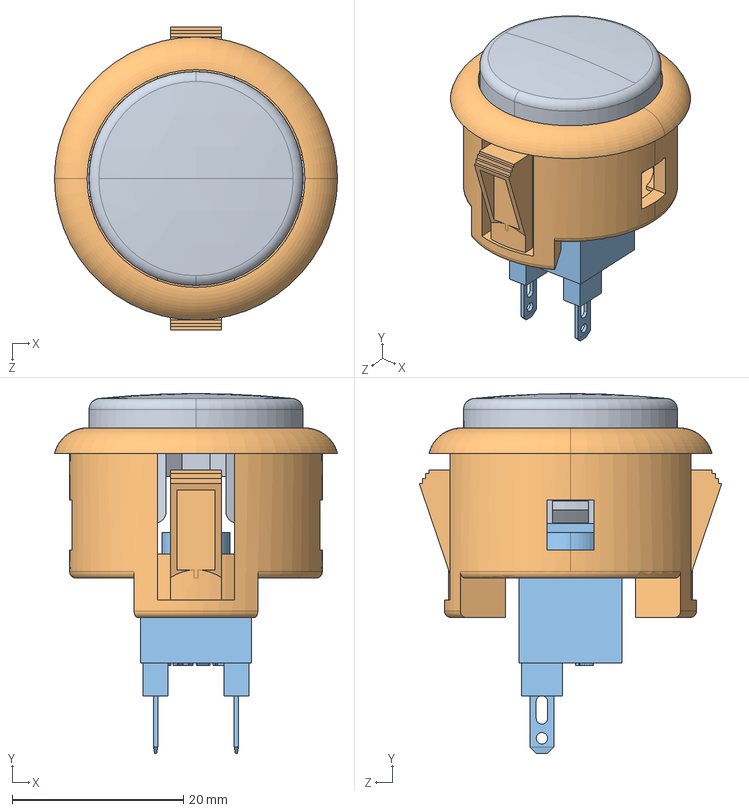
[picture p153: CAD file, 2016-06-20]
SolidWorks Project/arcade-button-sanwa-obsf-30-g.snapshot.2/sanwa obsf-30-g.STEP
33.0 x 42.0 x 35.3 mm
top_cap
base
microswitch
