LeoWPereira/Dalle-Pad/SolidWorks Project/Dalle Pad/madeira/Base de madeira.SLDPRT

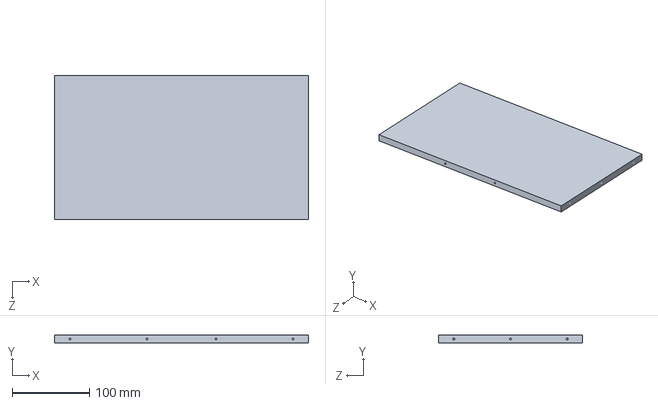
[picture p154: CAD file, 2016-06-20]
SolidWorks Project/Dalle Pad/madeira/Base de madeira.SLDPRT
329.5 x 10.0 x 187.0 mm
