LeoWPereira/Dalle-Pad/SolidWorks Project/Dalle Pad/madeira/Capa frontal.SLDPRT

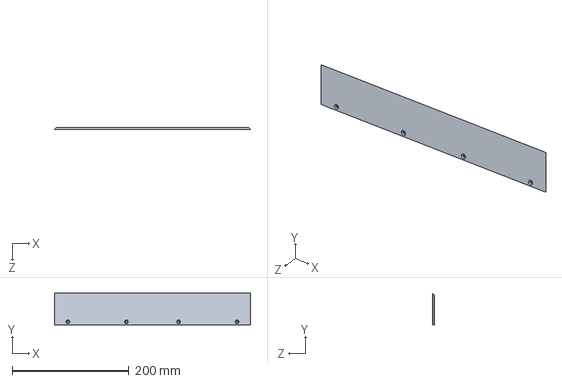
[picture p155: CAD file, 2016-06-20]
SolidWorks Project/Dalle Pad/madeira/Capa frontal.SLDPRT
335.5 x 54.0 x 3.00 mm
