LeoWPereira/Dalle-Pad/SolidWorks Project/Dalle Pad/madeira/Capa Superior.SLDPRT

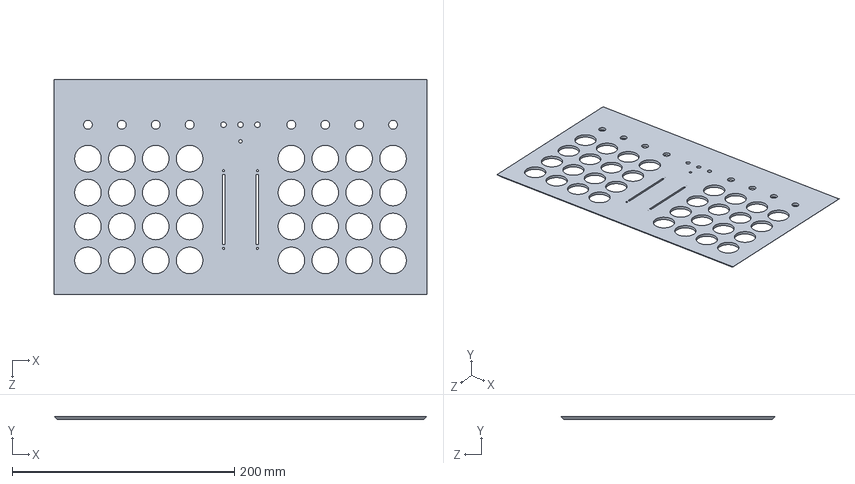
[picture p156: CAD file, 2016-06-20]
SolidWorks Project/Dalle Pad/madeira/Capa Superior.SLDPRT
335.5 x 3.00 x 193.0 mm
