LeoWPereira/Dalle-Pad/(list of files, cad)

Other CAD files:
SolidWorks Project/potentiometer-10k-1.snapshot.3/potentiometer 10k.STEP
SolidWorks Project/Dalle Pad/madeira/Capa direita.SLDPRT
SolidWorks Project/Dalle Pad/MIDI SHIELD.SLDDRW
SolidWorks Project/Dalle Pad/madeira/Base de madeira.SLDDRW
SolidWorks Project/Dalle Pad/madeira/Capa direita.SLDDRW
SolidWorks Project/Dalle Pad/madeira/Capa esquerda.SLDDRW
SolidWorks Project/Dalle Pad/madeira/Capa frontal.SLDDRW
SolidWorks Project/Dalle Pad/madeira/Capa traseira.SLDDRW
SolidWorks Project/Dalle Pad/madeira/Desenho Mecânico - Capa Superior.SLDDRW
SolidWorks Project/arcade-button-sanwa-obsf-30-g.snapshot.2/sanwa obsf-30-g.stl
SolidWorks Project/arduinomega-1.snapshot.2/Arduino Mega 2560.SLDPRT
SolidWorks Project/arduinomega-1.snapshot.2/Arduino Mega 2560.x_b
SolidWorks Project/potentiometer-10k-1.snapshot.3/POTENTIOMETER.SLDPRT
