LeoWPereira/Dalle-Pad/Album/Full Songs/Equinox Give-Away Project/Step 1 - Launchpad Setup.jpg

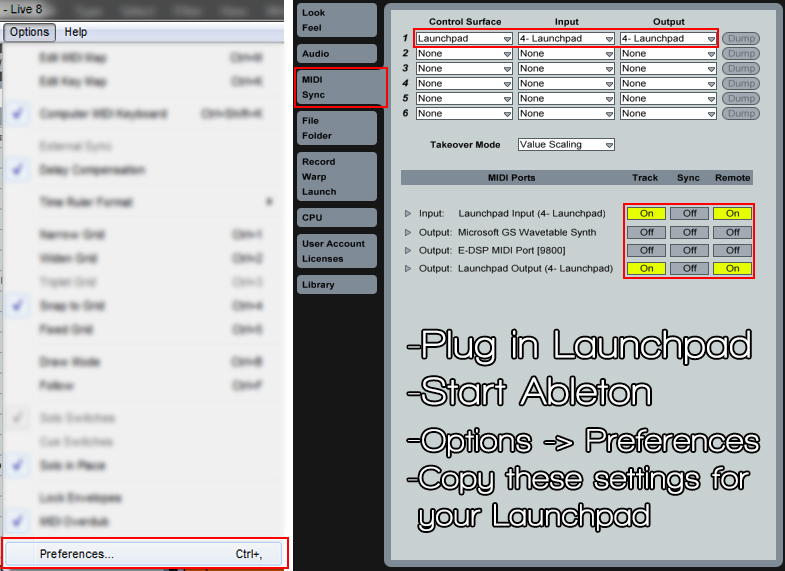
Album/Full Songs/Equinox Give-Away Project/Step 1 - Launchpad Setup.jpg
