LeoWPereira/Dalle-Pad/Album/Full Songs/Equinox Give-Away Project/Step 2 - Project Setup.jpg

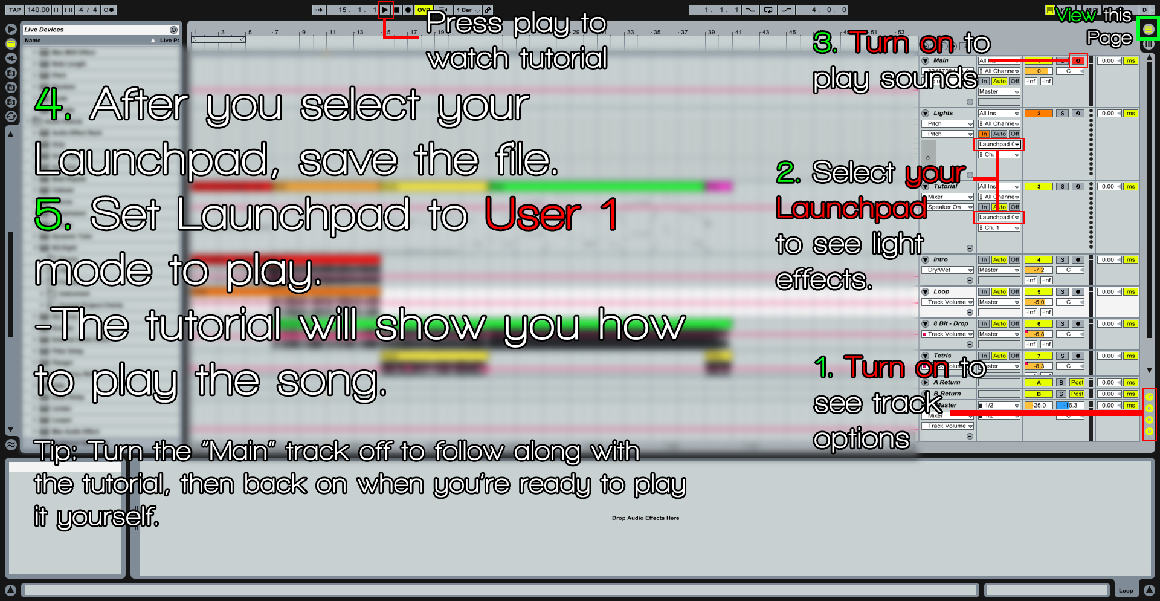
Album/Full Songs/Equinox Give-Away Project/Step 2 - Project Setup.jpg
