LeoWPereira/Dalle-Pad/SolidWorks Project/Dalle Pad/madeira/Desenho Mecânico - Base de madeira.pdf

E

F

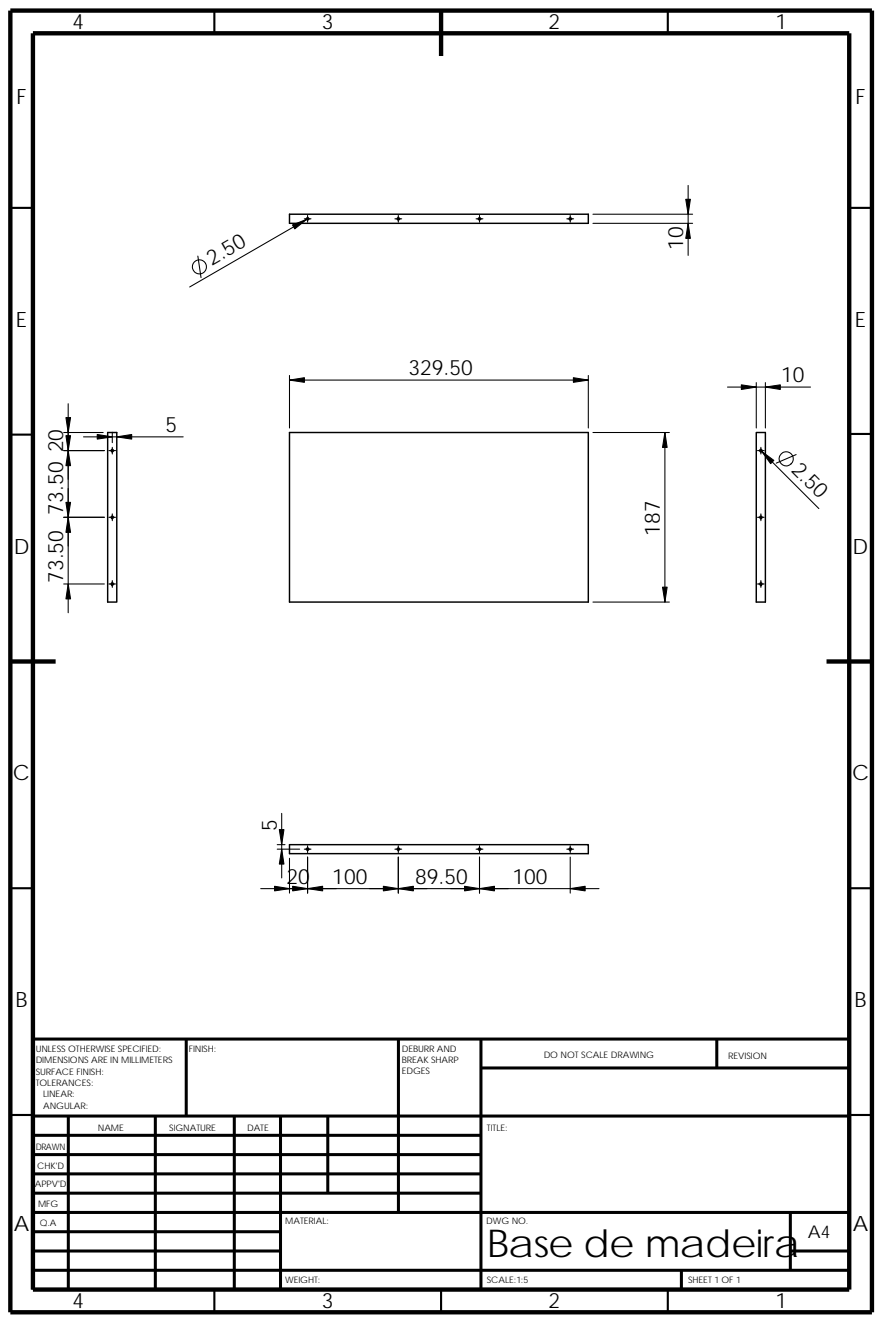
[picture p160: page 1]
SHEET 1 OF 1; WEIGHT:; SCALE:1:5; DO NOT SCALE DRAWING; REVISION; FINISH:; EDGES; DEBURR AND BREAK SHARP

UNLESS OTHERWISE SPECIFIED:
DIMENSIONS ARE IN MILLIMETERS
SURFACE FINISH:
TOLERANCES:
LINEAR:
ANGULAR:

NAME | SIGNATURE | DATE | | | | TITLE:

DRAWN
CHK'D
APPV'D
MFG
Q.A | | | | MATERIAL: | DWG NO. Base de madeira | A4
