LeoWPereira/Dalle-Pad/SolidWorks Project/Dalle Pad/madeira/Desenho Mecânico - Capa esquerda.pdf

E

F

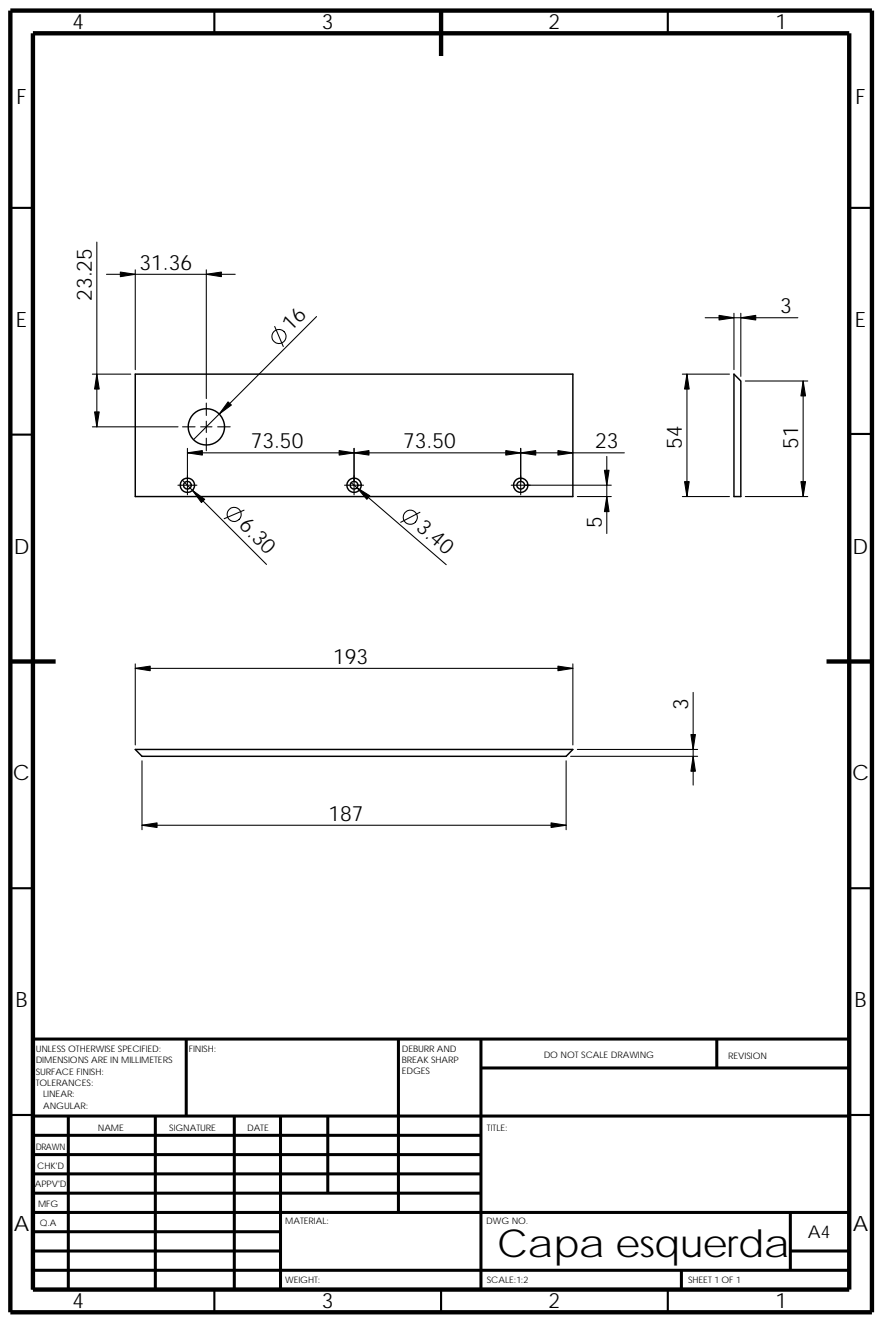
[picture p161: page 1]
WEIGHT:; SCALE:1:2; SHEET 1 OF 1; REVISION; ANGULAR:; LINEAR:; FINISH:; TOLERANCES:; EDGES; SURFACE FINISH:; DEBURR AND BREAK SHARP

DO NOT SCALE DRAWING UNLESS OTHERWISE SPECIFIED: DIMENSIONS ARE IN MILLIMETERS

NAME | SIGNATURE | DATE | | | | TITLE:

DRAWN
CHK'D
APPV'D
MFG
Q.A | | | | MATERIAL: | DWG NO. Capa esquerda | A4
